dzid26/ESP32-DualCAN/hardware/esp32-c6-super-mini-com-wifi-e-bluetooth-com-usb-c.jpg

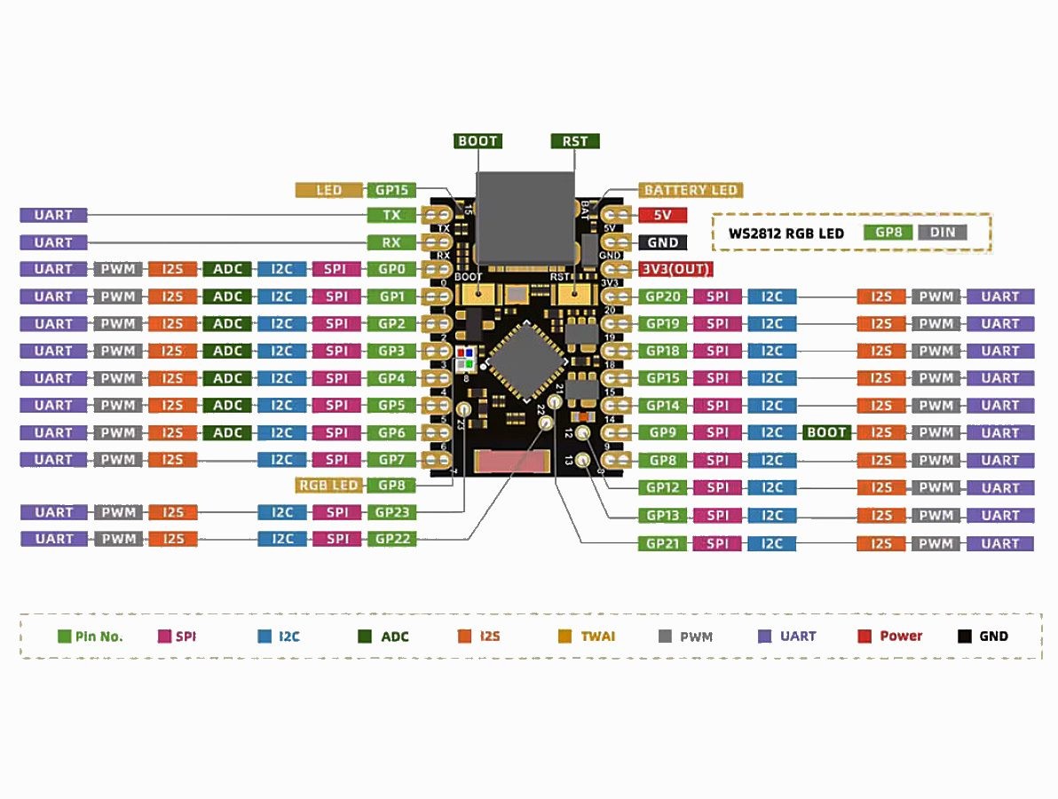
hardware/esp32-c6-super-mini-com-wifi-e-bluetooth-com-usb-c.jpg
