dzid26/ESP32-DualCAN/hardware/README.md

# Hardware — ESP32-DualCAN

 

## Characteristics
- 9-58 V operating range (e.g. Cybertruck),
- 5V rail: 0.5A continuous at room temp
- Dual CAN
- integrated 2.4 GHz antenna
- RGB LED
- USB-C - USB CDC (virtual COM, debugging)  

## Case
Designed in FreeCAD
- size 23.5 x 42.8 x 12.3 mm

## ICs
- ESP32-C6-Zero (ESP32-C6FH8, 8MB, BLE + WiFi, 2x TWAI CAN2.0 controllers)
- 2x CAN transceivers TCAN1044
- TI LV2862 DC/DC converter

## PCB
Designed in Kicad
- size 19.5 x 41.5 mm

## Images
- ESP32-C6-Zero chiplet and Molex connector:



- On the other side there are components and optional pads to solder cables with a female [connector](https://duckduckgo.com/?q=MX2.54+cable+6p) to daisy chain with s3xy buttons or a strip:



- It can accommodate optional female 2.54mm headers for custom extensions:



## Schematic



Source files: [`ESP32-DualCAN.kicad_sch`](ESP32-DualCAN.kicad_sch), [`ESP32-DualCAN.kicad_pcb`](ESP32-DualCAN.kicad_pcb) — see [KiCad-Waveshare-ESP32/](KiCad-Waveshare-ESP32/) for the ESP32-C6-Zero module footprint.
