dzid26/ESP32-DualCAN/hardware/KiCad-Waveshare-ESP32/README.md

# Waveshare ESP32-C6-Zero KiCad Footprint & Symbol

This is a KiCad Symbol and Footprint library for some select Waveshare ESP32 boards.
