dzid26/ESP32-DualCAN/docs/scripting.md

# Dorky Commander — Scripting Reference

> **💡 This is where the fun begins.** You can turn your commander into a smart device that reacts to the car CAN signals. Dive in!

> Scripting is based on Berry - a Python like language: <https://berry-lang.github.io/>

Scripts are `.be` files stored on LittleFS under `/scripts/`. Saving can also
write a `.bep` preprocessed runtime file with DBC names linked to numeric refs.
Each source file can carry metadata comments at the top and must define a `setup()` function.

## Script structure

```berry
# @name My script
# @description What it does
# @bus 0

var my_var = 0

def setup()
  # called when the script is enabled — register callbacks and timers here
  timer_every(1000, def()
    print("tick " .. str(my_var))
    my_var += 1
  end)
end

def teardown()
  # called when the script is disabled (optional)
  print("bye")
end
```

Metadata fields (`@name`, `@description`, `@bus`) appear in the web UI.

## Function reference

### High-level API *(user-facing — write these directly in scripts)*

**High-level API** (write these directly; the preprocessor resolves the DBC name forms described below):

| Function | Returns | Description |
|---|---|---|
| `can_msg_new(name)` | draft \| nil | Create zeroed draft from DBC name (name→ID+DLC resolved at compile time) |
| `can_msg_new(id, dlc)` | draft \| nil | Create zeroed draft from numeric ID and DLC |
| `can_msg_get(bus, id \| name)` | draft \| nil | Latest received frame as editable draft — bus is first |
| `can_msg_send(bus, draft)` | — | Transmit the draft on bus (auto-handles checksum/counter) |
| `can_send_raw(bus, id, data)` | — | Transmit a raw CAN frame (max 8 bytes) |
| `can_recv_raw(bus, msg_id [, timeout_ms])` | bytes \| nil | Last payload for a CAN ID. Default 1000 ms timeout — blocks up to 1 s for initial data. Pass 0 for instant return. |
| `timer_after(ms, fn)` | handle | Fire fn once after ms |
| `timer_every(ms, fn)` | handle | Fire fn every ms |
| `timer_cancel(handle)` | — | Cancel a timer by handle |
| `action_register(name, fn)` | — | Register a Dashboard tile |
| `action_invoke(name)` | — | Invoke an action by name |
| `led_set(r, g, b)` | — | On-board RGB LED (0–255 each) |
| `led_off()` | — | Turn off LED |
| `state_set(key, val)` | — | Write string to NVS flash |
| `state_get(key [, default])` | str \| nil | Read string from NVS flash |
| `state_remove(key)` | — | Delete key from NVS flash |
| `millis()` | int | Milliseconds since boot |
| `print(msg)` | — | Log to web UI panel |
| `str(v)` | string | Convert any value to string |
| `format(fmt, ...)` | string | C-style string formatting |

Timers and actions belong to the script that registered them, including when
they are registered from inside a timer callback or an action. Disabling the
script cancels them. `teardown()` runs before that sweep, so a timer started
from `teardown()` is cancelled too — `teardown()` cannot defer work.

**Renamed or rewritten by the preprocessor** (the call you write is replaced
at compile time — writing them without a DBC loaded will produce errors):

| Source (what you write) | Becomes (after preprocessing) |
|---|---|---|
| `can_msg_get(bus, "msg")` | `can_msg_get(bus, 0xID)` |
| `can_msg_new("msg")` | `can_msg_new(0xID, dlc)` |
| `msg_sig_set(draft, "sig", val)` | `msg_sig_set(draft, sb, len, be, signed, scale, offset, val)`, the full encode with scale and offset |
| `msg_sig_get(draft, "sig")` | `msg_sig_get(draft, sb, len, be, signed, scale, offset)`, the full decode with scale and offset |

The preprocessor reads source with the same lexical rules as the firmware Berry
compiler. `#` line comments and `#- ... -#` block comments are ignored; strings
use either quote style, support Berry escapes, and adjacent literals
(`"DAS_" "bodyControls"`) are one name. A string cannot contain a raw newline.
Calls must put `(` immediately after the name. `can_msg_get (0, "msg")` is a
grouping expression to Berry, not a call, so the preprocessor reports it
instead of silently repairing it.

These calls can nest. The common case is incrementing a counter field in place:

```berry
var msg = can_msg_get(0, "UI_powertrainControl")
msg_sig_set(msg, "UI_powertrainControlCounter",
  (int(msg_sig_get(msg, "UI_powertrainControlCounter")) + 1) % 16)
```

The inner read is inlined to full metadata and the outer write keeps the whole
expression intact.

Diagnostics carry `line:column`. Saving is blocked when a message or signal name
is unknown, a name is not a compile-time string literal, the argument count is
wrong, a tracked draft's message does not contain the signal, or a call is
unbalanced. A balanced call that cannot be resolved is replaced with
`assert(false, "message")`, which is valid Berry in expression position. The
rest of the file is still preprocessed. An unbalanced call is left in place and
reported, and the upload is blocked.

When a signal name appears in more than one message and the draft's owning
message cannot be determined (an untracked or multi-assigned variable), the
first match is used and a non-fatal **warning** is reported in the web UI.
The owning message comes from a tracked variable or from an inline
`can_msg_get`/`can_msg_new` call. Bind the draft so resolution is exact.

`can_msg_new` accepts `"msg"` or `(id, dlc)`. For compatibility it also accepts
`("msg", ignored)` and `(ignored, "msg")`. The DBC's ID and DLC are used. A
one-argument numeric call such as `can_msg_new(0x294)` is rejected because the
runtime binding requires both ID and DLC.

The four names are treated as the firmware intrinsics when called directly. A
definition such as `def can_msg_get(x)` is left alone, and a member call such as
`obj.can_msg_get(...)` is left alone. A later direct call to the intrinsic name
is still rewritten even if that name was shadowed. A call through a different
alias is not recognized. Calls inside f-string interpolation are not rewritten.
Build the string after the call. A non-literal second argument to
`can_msg_get` is left for the runtime, so `can_msg_get(0, msgIdVar)` remains
valid for a numeric ID.

### Low-level inline forms *(generated by the preprocessor. Do not write these manually.)*

| Generated form | Meaning |
|---|---|
| `can_msg_get(bus, 0xID)` | latest frame for a numeric message ID |
| `can_msg_new(0xID, dlc)` | zeroed draft from a numeric ID and DLC |
| `msg_sig_get(draft, sb, len, be, signed, scale, offset)` | decode a signal |
| `msg_sig_set(draft, sb, len, be, signed, scale, offset, val)` | encode a signal |

`sb` is the start bit, `len` is the bit length, `be` is big-endian, `signed` is
signed, and `scale` and `offset` are the DBC conversion. These are what a `.bep`
contains. Write the named calls in `.be` source.

---

## CAN signals  *(requires a DBC loaded on the target bus)*

```berry
# Poll a signal via message draft + timer.
# can_msg_get returns the latest received frame for a given bus + message ID.
var d = can_msg_get(0, "VCRIGHT_doorStatus")
if d != nil
  var v = msg_sig_get(d, "VCRIGHT_frontHandlePulled")
  print("handle: " .. str(v))
end

# Read current value synchronously (returns a map or nil).
var d = can_msg_get(0, "DI_speed")
var m = 0
if d != nil m = msg_sig_get(d, "DI_vehicleSpeed") end
if m != nil
  print("speed: " .. str(m['value']))
end
```

## Raw CAN frames

```berry
# Send a raw frame: bus (0 or 1), CAN ID (integer), payload (bytes object, max 8).
var b = bytes("01FF")               # from hex string
can_send_raw(0, 0x100, b)

# Using setbits(offset_bits, len_bits, val) — chainable, returns self.
# UI_mirrorFoldRequest at bit 24, 2 bits, value 0x2 (unfold):
can_send_raw(0, 0x273, bytes(-8).setbits(24, 2, 0x2))

# Read the last received payload bytes for a specific CAN ID:
# Default timeout is 1 s — blocks up to 1 s for initial data.
# Pass timeout_ms=0 for instant return (retuns nil if no data yet).
var payload = can_recv_raw(0, 0x118)
if payload != nil
  print("DI_state: " .. str(payload))
end
```
Note: long timeouts are not recommended - as they block all berry scripts.

## Encoded messages  *(requires DBC)*

```berry
# Create a fresh zeroed draft from DBC (name → ID + DLC resolved at compile time)
var msg = can_msg_new("UI_powertrainControl")
# Or with numeric ID, DLC:  can_msg_new(0x313, 8)
msg_sig_set(msg, "UI_trackModeRequest", 1)
can_msg_send(0, msg)                           # bus, msg

# Or fetch the latest received frame as a modifiable draft
var msg2 = can_msg_get(0, "UI_powertrainControl")   # bus first, then DBC name
# or by numeric CAN ID: can_msg_get(0, 0x313)
msg_sig_set(msg2, "UI_trackModeRequest", 1)
can_msg_send(0, msg2)
```

The draft is a map instance with keys `id` (int), `data` (bytes), `dlc` (int). You can read/write individual signals with `msg_sig_set`, or access the raw data buffer directly: `msg["data"]`.

### Low-level bit encoding (used by the preprocessor, exposed for custom work)

```berry
# Extract a raw integer bit field from bytes.
var raw = bit_extract(data, 0, 2, false)   # start_bit=0, len=2, little_endian

# Insert a raw integer into bytes, returns a new bytes copy.
var encoded = bit_insert(data, 0, 2, false, 3)

# Decode/encode are done via msg_sig_get / msg_sig_set on a draft — see below.
```

### AI authoring guidance

When writing scripts that inject a vehicle command frame, send only the intended command frame unless the user explicitly asks for a release/reset frame. No need to set up periodic reset - the vehicle will take care of resetting the state back to idle or similar.

---

## Timers

```berry
# Fire once after 500 ms. Returns a handle (int).
var h1 = timer_after(500, def()
  print("fired once")
end)

# Fire every 200 ms. Returns a handle (int) for cancellation.
var h2 = timer_every(200, def()
  print("every 200 ms")
end)

# Cancel by handle (no-op if handle is invalid or already fired).
timer_cancel(h2)
```

---

## Actions  *(appear as tiles on the Events page)*

```berry
action_register("my_action", def()
  print("tile tapped")
  led_set(0, 40, 0)
  timer_after(200, /-> led_off())
end)

action_invoke("my_action")   # call programmatically
```

---

## LED

```berry
led_set(40, 0, 0)   # r, g, b  (0–255 each)
led_off()
```

---

## Persistent storage  *(NVS flash — survives reboot)*

```berry
state_set("my_key", "hello")          # write a string
var v = state_get("my_key", "fallback")  # read, with default
state_remove("my_key")                  # delete key
```

---

## Berry lang syntax cheat sheet

```berry
var x = 0                        # variable
x += 1                           # compound assignment

def greet(name)                  # function definition
  print("hi " .. name)
end

if x > 10                        # if / elif / else / end
  print("big")
elif x > 5
  print("medium")
else
  print("small")
end

for i: 0..4                      # range loop (inclusive on both ends)
  print(str(i))
end

while x > 0                      # while loop
  x -= 1
end

var fn = /-> print("lambda")     # zero-arg lambda
var fn2 = def(a) a * 2 end       # inline function expression

var b = bytes(-8)                 # fixed 8-byte buffer, zero-filled
b.setbits(24, 2, 2)               # signal at bit 24, 2 bits, value 2 (PRESENT)
var b2 = bytes('deadbeef0011')    # 8 bytes from hex string
b.item(0)                         # read by index
```

## `setbits`

Writes a bit-level value into a `bytes` buffer. Chainable — returns `self`.

Works natively with **Intel (little-endian) unsigned** DBC signals — the most common format. For Motorola (big-endian) or signed signals, convert offset/value before calling.

| Parameter | Unit | Range |
|---|---|---|
| `offset_bits` | bits | `0`+ |
| `len_bits` | bits | `1`..`32` |
| `val` | integer | uses only lower `len_bits` |

```berry
# arbitrary bit offset, no need for byte alignment
can_send_raw(0, 0x273, bytes(-8).setbits(24, 2, 2))
```

More here - [Berry-in-20-minutes](https://berry.readthedocs.io/en/latest/source/en/Berry-in-20-minutes.html)
