dzid26/ESP32-DualCAN/hardware/case/case.FCStd

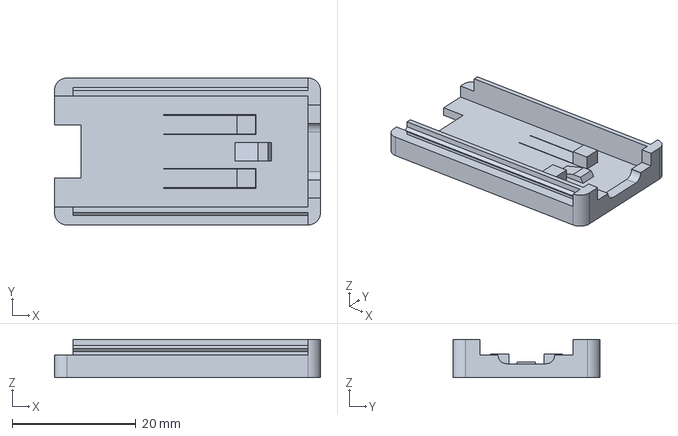
[picture p2: CAD file, 2026-04-22]
hardware/case/case.FCStd
43.0 x 23.8 x 6.20 mm
