dzid26/ESP32-DualCAN/hardware/footprints/CONN_1719760000.step

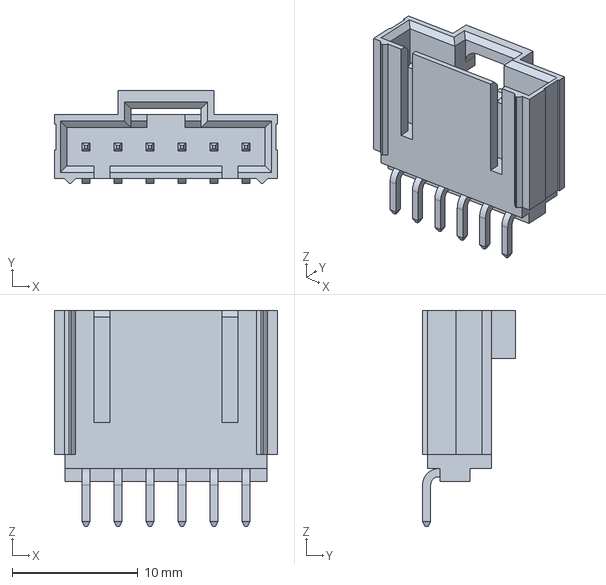
[picture p3: CAD file, 2026-03-16]
hardware/footprints/CONN_1719760000.step
17.7 x 7.38 x 17.1 mm
