dzid26/ESP32-DualCAN/hardware/footprints/CONN_705530005.step

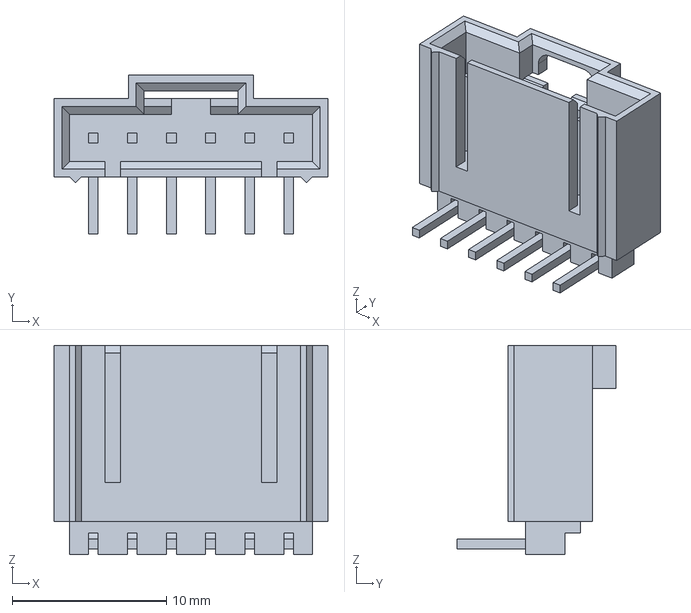
[picture p4: CAD file, 2026-03-16]
hardware/footprints/CONN_705530005.step
17.8 x 10.3 x 13.6 mm
