dzid26/ESP32-DualCAN/hardware/footprints/CONN_0705510040.step

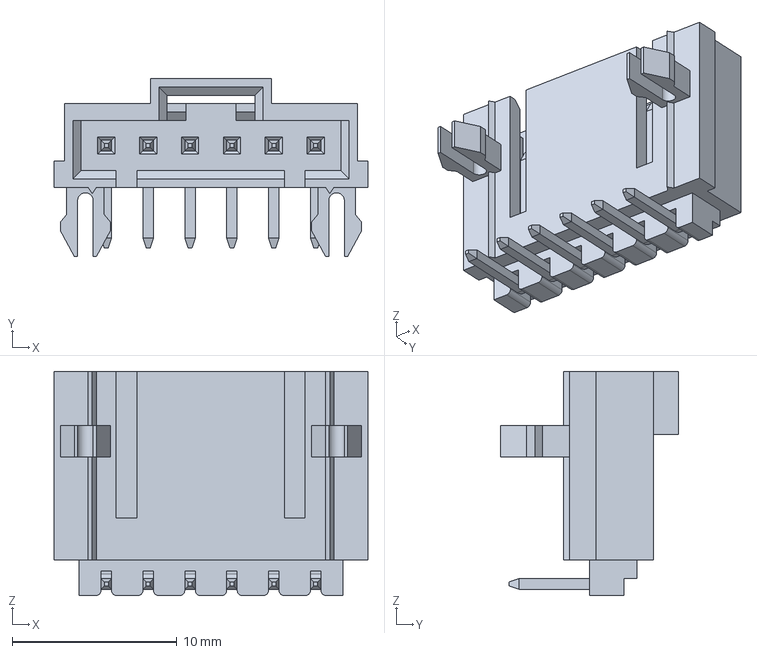
[picture p5: CAD file, 2026-02-19]
hardware/footprints/CONN_0705510040.step
19.0 x 10.8 x 13.6 mm
