dzid26/ESP32-DualCAN/hardware/ESP32-DualCAN.kicad_pcb

## KiCad design hardware/ESP32-DualCAN.kicad_pcb (2026-10-12)

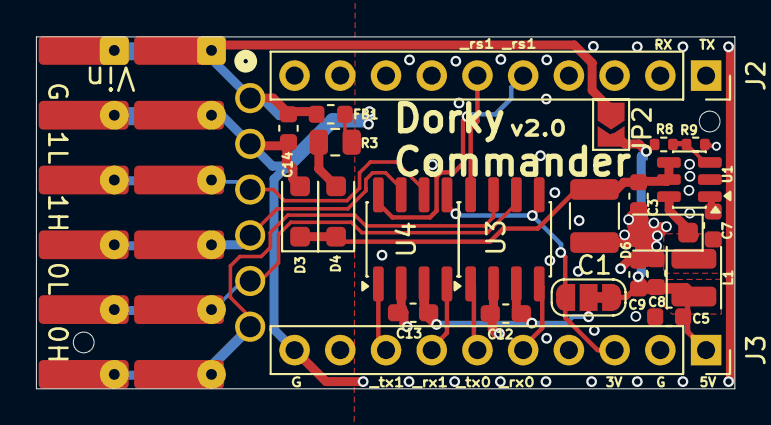
[picture p6: board ESP32-DualCAN.kicad_pcb from above]

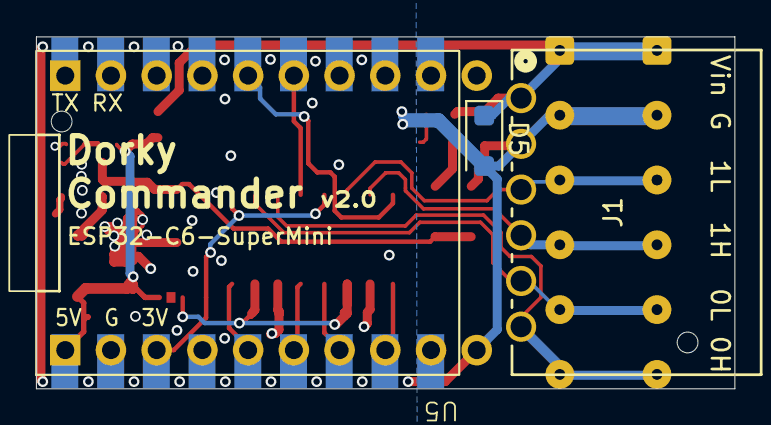
[picture p7: board ESP32-DualCAN.kicad_pcb from below]

Board: 2 copper layers, 38.8 x 19.6 mm, 31 parts (3 on the bottom side), 30 nets.

Parts:
C1: 10u 100v; C_1210_3225Metric
C3, C14: 100n 100V; C_0603_1608Metric
C5, C9: 22u; C_0603_1608Metric
C7, C8: 100n; C_0603_1608Metric
C12, C13: 100n; C_0603_1608Metric_Pad1.08x0.95mm_HandSolder
D3, D6: DSK38; D_SOD-123F
D4: SMF58A; D_SOD-123F
D5: SMF30CA; D_SOD-123F
FB1: FerriteBead; L_0603_1608Metric
J1: Molex 70553 6p; CONN_705530005_06_MOL
J2, J3: Conn_01x10_Socket; PinSocket_1x10_P2.54mm_Vertical
J4, J6: holes; SolderWire-0.1sqmm_1x06_P3.6mm_D0.4mm_OD1mm
J5, J7: pads; SolderWire-0.1sqmm_1x06_P3.6mm_D0.4mm_OD1mm
JP1: SolderJumper_3_Bridged12; SolderJumper-3_P1.3mm_Bridged12_RoundedPad1.0x1.5mm_NumberL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
JP2: SolderJumper_2_Open; SolderJumper-2_P1.3mm_Open_TrianglePad1.0x1.5mm
L1: 22uH; L_Changjiang_FTC322520S
R3: 1ohm; R_0805_2012Metric
R8: 56k; R_0402_1005Metric
R9: 10k; R_0402_1005Metric
U1: MLMR16006Y; TSOT-23-6
U3, U4: TCAN1044AV; SOIC-8_3.9x4.9mm_P1.27mm
U5: ESP32-C6-Zero; Waveshare-ESP32-C6-Zero

Connections:
+3.3V: J3.3, JP1.3 (B), U3.5 (VIO), U4.5 (VIO), U5.3 (V3V)
+BATT: C14.1, D5.1 (A1), FB1.1, J1.1, J4.1, J5.1, J6.1, J7.1, JP2.1 (A)
/BATT_Diode: C1.1, C3.1, D3.1 (K), D4.1 (A1), U1.4 (EN), U1.5 (VIN)
CAN0_H: J1.6, J4.6, J5.6, J6.6, J7.6, U3.7 (CANH)
CAN0_L: J1.5, J4.5, J5.5, J6.5, J7.5, U3.6 (CANL)
CAN0_RS: J2.6, U3.8 (STB), U5.13 (IO19)
CAN0_RXD: J3.5, U3.4 (RXD), U5.5 (IO1)
CAN0_TXD: J3.6, U3.1 (TXD), U5.6 (IO2)
CAN1_H: J1.4, J4.4, J5.4, J6.4, J7.4, U4.7 (CANH)
CAN1_L: J1.3, J4.3, J5.3, J6.3, J7.3, U4.6 (CANL)
CAN1_RS: J2.5, U4.8 (STB), U5.14 (IO18)
CAN1_RXD: J3.7, U4.4 (RXD), U5.7 (IO3)
CAN1_TXD: J3.8, U4.1 (TXD), U5.8 (IO4)
GND: C1.2, C3.2, C5.2, C8.2, C9.2, C12.2, C13.2, C14.2, D4.2 (A2), D5.2 (A2), D6.2 (A), J1.2, J3.2, J3.10, J4.2, J5.2, J6.2, J7.2, R9.1, U1.2 (GND), U3.2 (GND), U4.2 (GND), U5.2 (GND)
unnamed: D3.2 (A), R3.2
unnamed: C7.2, D6.1 (K), L1.1, U1.6 (SW)
unnamed: FB1.2, R3.1
unnamed: J2.1, U5.18 (TX)
unnamed: J2.2, U5.17 (RX)
unnamed: J2.3, U5.16 (IO14)
unnamed: J2.4, U5.15 (IO15)
unnamed: J2.7, U5.12 (IO20)
unnamed: J2.8, U5.11 (IO21)
unnamed: J2.9, U5.10 (IO22)
unnamed: J3.4, U5.4 (IO0)
unnamed: J3.9, U5.9 (IO5)
unnamed: C12.1, C13.1, JP1.2 (C), U3.3 (VCC), U4.3 (VCC)
unnamed: C7.1, U1.1 (BOOST)
unnamed: R8.1, R9.2, U1.3 (FB)
VCC: C5.1, C8.1, C9.1, J3.1, JP1.1 (A), JP2.2 (B), L1.2, R8.2, U5.1 (VCC)
