dzid26/ESP32-DualCAN/firmware/src/can/can.h

#pragma once

#include <stdbool.h>
#include <stdint.h>

#include "driver/twai.h"
#include "can/rate_limit.h"

#define CAN_MSG_CACHE_MAX   64  /* number of CAN IDs that can be cached */
#define CAN_FRAME_CACHE    3  /* ring buffer depth per cache slot */

/* CAN-layer error codes */
#define CAN_ERR_FULL    (-202)
#define CAN_ERR_NO_FRAME (-203)

/* Ring buffer of twai_message_t at fixed depth (CAN_FRAME_CACHE).
 * frames[0].identifier == 0 means a cache slot is free.
 * last_us = esp_timer_get_time() at most recent push (microseconds). */
typedef struct {
    twai_message_t frames[CAN_FRAME_CACHE]; // mini ring buffer
    uint8_t        head;     /* next write index */
    uint8_t        count;    /* frames stored (0..CAN_FRAME_CACHE) */
    uint32_t       last_us;  /* μs timestamp of most recent push */
} msg_ring_t;

typedef struct {
    int                bus_id;
    rate_limiter_t     rate_limiter;
    bool               loaded;
    bool               sim_mode;       /* true = TX goes to log, not bus */

    /* Frame cache: per-ID ring buffers. Only caches IDs scripts have read. */
    msg_ring_t         msg_cache[CAN_MSG_CACHE_MAX];
} can_t;

int  can_init(can_t *c, int bus_id);
void can_free(can_t *c);
int  can_poll(can_t *c, uint32_t now_ms);

/* Raw frame observer — called for every frame received on any bus.
 * Used by the trace feature to forward frames to the UI. Single global slot. */
typedef void (*can_raw_observer_t)(int bus_id, const twai_message_t *frame, uint32_t now_ms);
void     can_set_raw_observer(can_raw_observer_t cb);
uint32_t can_last_rx_ms(int bus_id);  /* ms timestamp of last received frame, 0 if none */
uint16_t can_bus_rx_rate(int bus_id); /* RX frames/sec over last ~1 s, 0 when idle */

/* Non-blocking (timeout_ms == 0) or blocking read (default 1000 ms):
 * ensure msg_id slot exists, returns last frame data when available or -1. */
int  can_read(can_t *c, uint32_t msg_id, uint8_t *out_data, uint8_t *out_dlc, uint32_t timeout_ms);

/* Send a raw CAN frame. Rate-limited per ID. */
int  can_send(can_t *c, uint32_t id, const uint8_t *data, uint8_t dlc);

void can_set_sim_mode(can_t *c, bool enabled);
