dzid26/ESP32-DualCAN/(commit log)

2026-02-19 ESP32-C6-MINI-1 + SN65HVD230 + USB-C
    [CONN_0705510040.step, ESP32-DualCAN.kicad_pcb, ESP32-DualCAN.kicad_sch]
2026-03-10 Moved CAN0 pins. Added UART tap points.
    [ESP32-DualCAN.kicad_pcb, ESP32-DualCAN.kicad_sch]
2026-03-16 ESP32-C6-Zero main
    [CONN_1719760000.step, CONN_705530005.step, ESP32-DualCAN.kicad_pcb, ESP32-DualCAN.kicad_sch]
2026-03-16 ESP32-C6-SuperMini as main
    [ESP32-DualCAN.kicad_pcb, ESP32-DualCAN.kicad_sch]
2026-03-23 horizontal layout
    [ESP32-DualCAN.kicad_pcb]
2026-03-23 /PCB folder
    [CONN_0705510040.step, CONN_1719760000.step, CONN_705530005.step, ESP32-DualCAN.kicad_pcb, ESP32-DualCAN.kicad_sch]
2026-04-12 Fixed silk labels
    [ESP32-DualCAN.kicad_pcb]
2026-04-14 firmware: add hardware-in-the-loop test scaffolding
    - TWAI dual-CAN loopback test (test_hw_loopback) and RGB LED smoke
    test (test_hw_led) running on ESP32-C6-SuperMini under the Arduino
    framework via pioarduino.
    - Custom unity_config.{h,cpp} that skips Serial.end() in
    unityOutputComplete() — on ESP32-C6 HWCDC that call pulls USB D+/D-
    low and kills enumeration until a hardware reset
    (platformio-core#5359).
    - Minimal platformio.ini for `pio test -e esp32-c6-tests-arduino`,
    plus .gitignore for generated sdkconfig / caches.
    [test_loopback.cpp, unity_config.cpp]
2026-04-16 firmware: add ESP-IDF production skeleton, architecture docs, native tests
    - Minimal ESP-IDF app (CMakeLists.txt, src/CMakeLists.txt, src/main.c,
    sdkconfig.defaults) routing ESP_LOG to USB-Serial-JTAG since UART0 is
    not broken out on the ESP32-C6-SuperMini.
    - platformio.ini gains a tests-native env for host unit tests alongside
    the existing esp32-c6-tests-arduino HIL env.
    - ARCHITECTURE.md spec and ROADMAP.md phased plan covering the
    firmware, scripting engine (Berry), dual BLE/WS transport, web UI,
    reverse-engineering tools, and test strategy.
    - First host unit test (test_native_checksum) covering the Tesla CAN
    checksum algorithm with hand-computed vectors.
    - Tesla Model 3 DBCs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
    [main.c]
2026-04-16 rename PCB/ to hardware/
    Align folder name with its broader scope (KiCad project, footprints,
    fabrication config, reference images). Updates the two path references
    in firmware/ARCHITECTURE.md.
    [CONN_0705510040.step, CONN_1719760000.step, CONN_705530005.step, ESP32-DualCAN.kicad_pcb, ESP32-DualCAN.kicad_sch]
2026-04-16 firmware: declare 4 MB flash for ESP32-C6-SuperMini
    The esp32-c6-devkitm-1 board preset assumes 2 MB, but the SuperMini
    module ships with 4 MB. `board_upload.flash_size = 4MB` is read by the
    espressif32 ESP-IDF builder and auto-propagates to sdkconfig as
    CONFIG_ESPTOOLPY_FLASHSIZE_4MB so the partition table and bootloader
    are sized for the actual chip.
    Also drop the redundant `build_type = release` — release is PIO's
    default and setting it explicitly just adds noise.
2026-04-16 firmware: port dual-TWAI bringup into production code
    - src/can/can_bus.{h,c}: thin wrapper over the TWAI v2 driver with
    install / send / receive / status for up to two buses. Drives the
    TCAN1044 STB pin low on install so the transceiver leaves standby.
    - main.c: init both buses at 500 kbit/s on the SuperMini pins
    (CAN0: GPIO2/1/19, CAN1: GPIO4/3/18), TX a tick frame on ID 0x123
    on CAN0 every second, drain and log any RX from both buses, toggle
    GPIO 15 LED as a liveness indicator.
    - src/CMakeLists.txt: narrow glob to .c/.cpp, add INCLUDE_DIRS "." so
    "can/can_bus.h" resolves, and declare REQUIRES esp_driver_twai
    esp_driver_gpio.
    - Verified on the board with the CAN0<->CAN1 bridg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
    [can_bus.c, main.c]
2026-04-16 firmware: integrate Berry scripting VM via submodule
    - Add berry-lang/berry as a git submodule at
    firmware/components/berry/berry/ (pinned at 3db3ef5, master).
    - ESP-IDF component wrapper in components/berry/CMakeLists.txt:
    compiles all upstream src/*.c except be_repl.c and be_filelib.c,
    plus our port/ files.
    - port/berry_conf.h tuned for ESP32-C6: single-precision float,
    32-bit integers, no filesystem, minimal module set (string, global,
    gc, introspect), stack max 2000, precompiled objects on.
    - port/be_port.c routes Berry's print() to ESP_LOGI, stubs all file
    I/O, provides be_nfunc_open() stub for the open() builtin.
    - port/be_modtab.c copied from upstream (module table control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
2026-04-16 firmware: Berry CAN loopback demo with RGB LED — phase 0 complete
    - Berry native bindings (src/scripting/berry_bindings.{h,c}):
    can_send(bus, id, data), can_receive(bus), led_set(r, g, b), led_off().
    Registered as global functions in the VM.
    - RGB LED driver (src/led/led_rgb.{h,c}): WS2812 on GPIO 8 via the
    espressif/led_strip managed component (src/idf_component.yml).
    - Demo script hardcoded in main.c: Berry loop() runs at 10 Hz, TX a
    counter frame on CAN0 (ID 0x123), poll CAN1 — green on rx, red on
    miss. Also bridges CAN0 rx to CAN1.
    - .gitignore: managed_components/ and dependencies.lock.
    Verified on hardware: LED glows green with CAN0<->CAN1 bridge jig.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
    [main.c]
2026-04-16 firmware: add free-heap and FreeRTOS CPU usage stats logging
    Print free heap and per-task CPU usage every 10 s. Requires a full
    rebuild after this change since sdkconfig.defaults enables
    FREERTOS_GENERATE_RUN_TIME_STATS and FREERTOS_USE_TRACE_FACILITY.
2026-04-16 ci: add GitHub Actions firmware workflow, update docs
    - .github/workflows/firmware.yml: host-tests job (pio test -e
    tests-native) and firmware-build job (pio run -e esp32-c6) with
    caching. Triggered on firmware/ changes.
    - ROADMAP.md: add AI-assisted script editor to parking lot, update
    phase 4 engine sound idea.
    - ARCHITECTURE.md: folder structure reflects current state.
    - platformio.ini: add monitor_rts/monitor_dtr=0 to prevent ESP32-C6
    USB-Serial-JTAG reset on monitor open.
2026-04-16 firmware: add DBC binary format, signal decoder, and signal cache
    Binary DBC format (dbc_types.h):
    - Compact memory-mappable format: 28-byte header, 12 bytes/message
    (sorted by ID for binary search), 16 bytes/signal, packed string
    table. Designed for zero-copy loading from a buffer.
    - Supports little-endian and big-endian signals, signed/unsigned,
    multiplexed messages (selector + muxed signals).
    Decoder (dbc_decode.{h,c}):
    - dbc_load(): validate and map a binary blob.
    - dbc_find_msg(): binary search by CAN ID.
    - dbc_find_signal(): linear scan by name.
    - dbc_extract_raw(): bit extraction for both Intel and Motorola byte
    order, handles arbitrary start_bit and bit_length up to 64 bits.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
2026-04-16 firmware: add message mirror with auto checksum/counter for TX
    msg_mirror.{h,c}: per-message latest-rx-bytes storage for the
    "modify one signal, preserve the rest" send pattern.
    - msg_mirror_rx(): update mirror on frame receipt.
    - msg_mirror_draft(): get a writable copy of the latest frame.
    - msg_mirror_prepare_tx(): auto-increment *_Counter signals (mod
    2^width) and auto-compute *_Checksum signals using the Tesla CAN
    checksum algorithm. Counter is incremented before checksum so the
    checksum covers the new counter value.
    - tesla_checksum() exported for direct use from Berry scripts.
    - Signal name suffix matching (_Counter, _Checksum) is
    case-sensitive, matching Tesla DBC conventions.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
2026-04-16 firmware: add CAN engine, decoded signal Berry bindings, embedded DBC
    CAN engine (src/can/can_engine.{h,c}):
    - Orchestrates DBC + signal cache + message mirror per bus.
    - can_engine_poll(): drains rx queue, decodes signals, updates cache
    and mirror, fires registered on-change callbacks.
    - can_engine_on_change(): register a C callback for a signal by name.
    - can_engine_signal(): look up current signal cache entry by name.
    - can_engine_draft/encode/send(): message draft→modify→transmit flow
    with auto checksum/counter.
    Berry bindings (extended berry_bindings.c):
    - can_signal(name [, bus]): returns map {value, prev, age_ms, changed}
    from the signal cache.
    - can_on(name, fn [, bus]): r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
    [main.c]
2026-04-16 firmware: add LittleFS, custom partition table, and script loader
    Partition table (partitions.csv): 4 MB flash split into NVS (16 KB),
    OTA data (8 KB), phy_init (4 KB), two 1.5 MB OTA app slots, and a
    960 KB LittleFS partition for scripts, DBC binaries, and web UI.
    LittleFS (storage/fs.{h,c}): mounts at /littlefs using the
    joltwallet/littlefs managed component. Auto-formats on first boot.
    Script loader (scripting/script_loader.{h,c}):
    - script_loader_scan(): reads /littlefs/scripts/ for .be files.
    - script_loader_enable(): reads file, executes it (defines functions),
    calls setup() if present. Errors are captured per-script.
    - script_loader_disable(): calls teardown(), marks script inacti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
    [partitions.csv]
2026-04-16 firmware: add NVS-backed state for Berry scripts
    state.{h,c}: thin wrapper over ESP-IDF NVS for per-script persistent
    key-value storage. state_nvs_init() called at boot. Values stored as
    strings, keyed by script namespace + key.
    Berry bindings:
    - state_set(key, value): store a string in NVS.
    - state_get(key [, default]): retrieve; returns default or nil if
    missing.
    - state_remove(key): delete a key.
    Currently uses a single "script" namespace. Will be per-script once
    the script loader assigns namespaces from filenames.
    [main.c]
2026-04-16 firmware: add BLE GATT server for web UI transport
    BLE transport (src/ble/ble_transport.{h,c}):
    - NimBLE GATT server advertising as "Dorky" with a custom service
    using Nordic UART Service-style UUIDs.
    - RX characteristic (write/write-no-rsp): client sends commands.
    - TX characteristic (notify): server pushes responses/events.
    - dorky_ble_init(): starts NimBLE host task + advertising.
    - dorky_ble_notify(): send data to connected client.
    - dorky_ble_connected(): connection status check.
    - GAP handler: auto-restarts advertising on disconnect, logs MTU
    negotiation and subscription events.
    - Preferred MTU set to 512 for Web Bluetooth compatibility.
    sdkconfig.defaults: enable BT + NimBLE, max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
2026-04-16 firmware: refactor CAN/DBC module structure for clarity
    Reorganize so file names match their purpose and Tesla-specific
    logic is isolated from generic CAN operations.
    Renames:
    can_bus.{h,c} → can_driver.{h,c} (TWAI hardware wrapper)
    can_engine.{h,c} → can.{h,c} (per-bus state, poll, callbacks)
    dbc_decode.{h,c} → split into dbc_pack + msg_codec
    New files:
    can/msg_codec.{h,c} — bit extract/insert, scale/offset, frame-level
    decode/encode, signal_state_t. Pure functions, no hardware deps.
    can/tesla.{h,c} — Tesla checksum + counter finalization. Pluggable
    via tx_finalize_fn_t function pointer for other brands.
    dbc/dbc_pack.{h,c} — load binary DBC blob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
2026-04-16 firmware: add per-ID TX rate limiter and simulation mode
    rate_limit.{h,c}: per-CAN-ID send throttle. Default 100 Hz, per-ID
    overridable via rate_limiter_set(). Tracks last-tx timestamp per ID
    in microseconds. Excess sends are silently dropped with a debug log.
    can.c integration:
    - can_send() checks rate_limiter_allow() before transmitting. Dropped
    frames log at DEBUG level to avoid flooding.
    - Simulation mode (can_set_sim_mode): when enabled, can_send() logs
    the frame instead of putting it on the bus. Useful for testing
    scripts without being in the car.
    [can.c, can.h, rate_limit.c, rate_limit.h]
2026-04-16 webui: scaffold Svelte 5 + Vite + TypeScript web UI
    Svelte 5 project at webui/ with three initial views:
    - Scripts: textarea editor for Berry code (Monaco will replace this).
    Upload & Enable / Disable buttons (wired to BLE transport).
    - DBC: file upload, browser-side DBC text parser + binary compiler
    (src/dbc/parser.ts — TypeScript port of firmware/scripts/dbc2bin.py).
    Displays parsed messages/signals. Upload to bus 0 or 1.
    - Dashboard: placeholder for live signal watch + graphs.
    Transport layer (src/transport/):
    - types.ts: Transport interface (connect, disconnect, send, onReceive).
    - ble.ts: BleTransport using Web Bluetooth API with Nordic UART
    Service UUIDs matching the firmwa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
2026-04-16 add demo scripts, CAN TX logging, and Tesla DBC preset in web UI
    Example Berry scripts (firmware/scripts_examples/):
    - loopback_led.be: CAN0→CAN1 loopback with RGB LED feedback.
    - bench_test.be: sends periodic frames on 3 IDs, logs rx, cycles LED.
    Designed for testing without a car — watch serial monitor.
    - window_drop_on_handle_pull.be: template for the door-handle window
    automation using decoded signals (can_on callbacks).
    - track_mode_on_full_throttle.be: template for track mode request.
    CAN TX logging: can_driver.c now logs every successful transmit at
    INFO level so sent frames are visible in pio device monitor.
    Web UI DBC view: "Load Tesla Model 3 defaults" button fetches the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
2026-04-18 case initial
    [case.FCStd]
2026-04-20 wire BLE protocol: script upload/enable/disable from web UI
    Adds a JSON-over-BLE request/response layer so the Scripts view can
    save, list, enable, and disable Berry scripts on the device without
    a manual reflash. Also fixes a Berry VM stack leak (be_getglobal
    always pushes; be_pop was missing in the no-loop-defined path,
    causing a watchdog trigger after ~480 idle iterations).
    - firmware/src/protocol/: new JSON framing layer (4-byte length
    prefix, cJSON dispatch, chunked BLE notify for large responses)
    - main.c: wire protocol_init + dorky_ble_init with real callback;
    remove dead demo script
    - CMakeLists.txt: add `json` component for cJSON
    - webui/src/transport/protocol.ts: Protocol clas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
    [main.c]
2026-04-20 fix script enable/disable and wire script delete; improve BLE reactivity
    - Fix Berry VM nil-callable crash: use be_isfunction() guard instead of
    be_getglobal() return value (which returns true even for nil globals)
    - Fix cross-script interference: remove blanket global nulling on disable;
    gate main loop on any_loaded check per-script instead
    - Add script.delete command (firmware protocol + script_loader_delete +
    TS client + del button in Scripts view)
    - Remove redundant top-row Enable/Disable buttons from Scripts UI
    - BLE reactivity: onConnectionChange callback keeps App.svelte connected
    state in sync on unexpected drops; pass reactive connected prop to views
    - Auto-reconnect on page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
    [main.c]
2026-04-21 wider cable slot
    [case.FCStd]
2026-04-22 buttons and fixes
    [case.FCStd]
2026-04-29 script loading - no loop() - use timer registration
    Firmware
    script_loader.c — assigns a unique script_id, captures setup/teardown into refs and clears the globals so scripts can't see each other's hooks; on disable it calls teardown via the captured ref then berry_cleanup_script(id) to revoke every tagged can.on / timer / action. Defining loop() now logs a warning telling the user to use timer_every.
    berry_bindings.c / .h — exposes berry_capture_global / release_ref / call_ref / timer_tick.
    main.c — dropped the loop() polling, calls berry_timer_tick(now) each iteration.
    bench_test.be — migrated to timer_every(100, tick_fn) registered from setup().
    Web UI
2026-04-29 Blink LED on CAN rx. CPU usage print
2026-04-29 Add Playwright E2E test suite with mock BLE transport
    - 10 smoke tests covering nav, connect flow, action tiles, disconnect state
    - Mock injects a fake GATT/NUS stack via addInitScript so tests run without
    hardware; handles all JSON-framed protocol ops (ping, script.list, action.list/invoke)
    - playwright.config.ts auto-detects system Chrome (NixOS nix-profile path)
    - Fix: default script template in Scripts view now shows setup()/teardown()
    pattern instead of deprecated loop()
    - Fix: Event.target is read-only — mock uses plain object instead of Event
2026-04-30 feat: Add log streaming and signal watch to Dashboard
    Berry print() is now overridden by a C binding that pushes
    {"type":"log","msg":"..."} frames over BLE; the Protocol client
    dispatches them via onLog(). Dashboard shows a scrollable log panel.
    A new signal.value protocol op reads can_signal() state on demand.
    Dashboard polls watched signals every 1 s; signal names are persisted
    to localStorage.
2026-04-30 examples: add hello_log.be, migrate loopback_led off loop()
    hello_log.be exercises the new Dashboard log panel and action tile
    plumbing without needing CAN traffic. loopback_led.be was still using
    the deprecated loop() global; rewrite it as setup() + timer_every.
2026-04-30 webui: harden Load Example dropdown against bind feedback loops
    The previous version used bind:value plus an onchange handler that
    reset the bound value, which (under Svelte 5 reactivity) could fire
    the change handler again with an empty value. Switch to a plain
    onchange that reads e.currentTarget.value and resets the DOM directly,
    removing the round-trip through state.
2026-04-30 webui: signal autocomplete + per-row bus + error tooltip in Watch
    Loaded DBC signals now flow through a small reactive store
    (dbcStore). The Dashboard signal-watch input gets a <datalist> for
    autocomplete and a per-row bus selector, defaulted to whichever bus
    the DBC was last uploaded to. Errors from signal.value calls show
    their actual message inline and as a tooltip instead of just "error".
2026-04-30 firmware: surface loop() deprecation warning to UI log panel
    berry_log_push() lets non-Berry code emit a line through the same
    push channel that Berry print() uses, so the script loader's warning
    about a deprecated loop() global now appears in the Dashboard log
    panel — not just on the serial console where users won't see it.
2026-04-30 tools: add Berry parse-check for example scripts
    scripts/parse_check_examples.sh builds a small native parse-checker
    against the bundled Berry sources and runs it over every .be in
    scripts_examples/. Catches syntax errors, malformed expressions, and
    references to globals that aren't on our binding list — all without
    flashing to a device.
    Berry's strict-globals compile pass requires every binding name to be
    visible at parse time, so parse_check.c pre-declares every binding we
    expose at runtime as a nil global. The list must stay in sync with
    be_regfunc() calls in src/scripting/berry_bindings.c.
2026-04-30 firmware: hook Berry log streaming via be_writebuffer
    The earlier approach registered a global called print and assumed it
    would shadow Berry's built-in. It doesn't — Berry compiles print()
    references directly to the built-in opcode, so the global override
    never fires and nothing reached the Dashboard log panel.
    Move the log handler into the Berry port layer where be_writebuffer
    already sees every character that built-in print() writes. The handler
    is set from protocol_init exactly as before; trailing newlines are
    trimmed so each push frame is a clean line.
2026-05-01 fix: reduce serial log noise and avoid redundant script.list calls
    - Suppress NimBLE per-notify INFO logs (set to WARN level)
    - Log "Enabled: <script>" before setup() so Berry print output follows it
    - Log script.write result with file count
    - Webui: optimistic enable/disable/delete updates avoid a round-trip script.list
2026-05-01 fix: move CAN tx/rx logs to DEBUG and fix Berry list subscript in examples
    can_driver: tx/rx now log at LOGD (silent by default, enable with
    idf.py -DLOG_LOCAL_LEVEL=ESP_LOG_DEBUG or esp_log_level_set).
    bench_test / loopback_led: rx[0]/rx[1] → rx.item(0)/rx.item(1).
    Berry BE_LIST is not a VM instance so the GETIDX opcode doesn't
    dispatch item() — must call it directly.
    [can_driver.c]
2026-05-01 fix: add per-bus RX ring buffer so Berry can_receive() sees polled frames
    can_poll() drained the TWAI hardware queue before berry_timer_tick() ran,
    so can_receive() always returned nil (loopback LED always red).
    can_poll() now pushes every received frame into a per-bus software ring
    buffer (depth 16). can_rx_pop() pops from it. l_can_receive() uses
    can_rx_pop() instead of reading TWAI directly, so Berry scripts see all
    frames that arrived since the last timer tick regardless of poll ordering.
    Also lower heap/tick log from every 1s to every 10s.
    [can.c, can.h, main.c]
2026-05-01 fix: move BLE dispatch to main task to eliminate Berry VM race
    The NimBLE task (gatt_access_cb) called dispatch_frame() directly,
    which ran script_loader_enable/disable and accessed the Berry VM.
    On ESP32-C6 (single-core) the NimBLE task can preempt the main task
    mid-berry_timer_tick(), corrupting VM state and causing hangs/timeouts.
    protocol_on_ble_write() now only reassembles frames and enqueues them
    via a FreeRTOS queue. protocol_tick() (called at the top of the main
    loop) drains the queue and dispatches, keeping all Berry VM access on
    the main task.
    [main.c]
2026-05-01 feat: persist script enabled state across reboots
    Adds script_loader_save_enabled() / script_loader_restore_enabled().
    Save writes SCRIPT_DIR/.enabled (one filename per line) whenever the
    user enables or disables a script via the protocol. Restore reads that
    file at boot (after scan) and re-enables only the listed scripts, so
    the set of running scripts survives power cycles.
    [main.c]
2026-05-01 fix: rate-limit blue LED blink and turn off RGB on loopback script disable
    Blue LED: only trigger a 50ms pulse at most once per 200ms so it blinks
    visibly (~5 Hz) rather than flickering at the frame rate.
    loopback_led: add teardown() calling led_off() so the RGB LED turns off
    when the script is disabled instead of staying on in its last colour.
    [main.c]
2026-05-01 feat: add disable-all / enable-all master toggle to script list
    A checkbox in the list header disables all enabled scripts when
    unchecked and enables all disabled scripts when checked. Label text
    tracks current state ('disable all' vs 'enable all').
2026-05-04 Fix LittleFS partition subtype
    [partitions.csv]
2026-05-04 fix: set flash size to 4MB to match ESP32-C6-SuperMini hardware
    ESP-IDF's Kconfig defaults ESPTOOLPY_FLASHSIZE to 2MB regardless of
    target, causing a mismatch warning when PlatformIO's board definition
    (correctly) specifies 4MB.
2026-05-04 chore: ignore hardware/case/export/ directory
2026-05-04 test: native test for per-ID TX rate limiter
    Covers default rate, per-ID overrides (tighter and looser), independent
    slots per id, table overflow, and the 0-Hz "unlimited" mode. Six cases,
    runs against the real rate_limit.c.
2026-05-04 refactor: extract length-prefixed framing into reusable helper
    protocol.c had the BLE rx framing (4-byte LE length prefix + payload)
    inlined as buffered bytes plus a drain loop. Pulled it out into
    frame_buf_t so it can be unit-tested and reused by a future WebSocket
    transport.
    Includes seven host tests covering BLE chunking corner cases: a frame
    in one append, one byte at a time, multiple frames in one append, the
    zero-length case, oversized length prefix, append overflow, and a
    consume() with no preceding peek.
2026-05-04 feat: simulation mode toggle from the UI
    can_set_sim_mode existed on the firmware side but had no way to be
    flipped at runtime. Add a sim.set op (with an optional bus filter)
    plus a checkbox strip on the Dashboard. When ON, every can_send is
    routed to the log instead of the bus — useful for developing scripts
    without being in the car.
2026-05-04 feat: live CAN trace view
    A first-class reverse-engineering tool: the firmware streams every
    received frame on subscribed buses, the UI renders them with id/bus
    filtering, pause, clear, and candump-format export.
    Firmware:
    - can_set_raw_observer() hook in can.c, called from can_poll() once
    per received frame on either bus.
    - protocol.c handles trace.start { buses: [0,1] } and trace.stop,
    pushes { type:"trace", bus, id, ts, data:hex } notifications.
    Auto-suppresses if no client is connected.
    WebUI:
    - Protocol.onTrace + traceStart/traceStop methods.
    - New Trace.svelte view with bus checkboxes, id filter (hex
    substring), pause/resume, clear, export. Frames are batched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
2026-05-05 feat: signal subscribe/push replaces 1 Hz polling on Dashboard
    Signal Watch was hammering the BLE link with one signal.value RPC per
    entry per second. Replace it with a subscribe model: the firmware pushes
    a {type:"signal"} frame on every decoded value change for subscribed
    (bus, name) pairs.
    Firmware (protocol.c):
    - signal.subscribe { name, bus } registers a can_on_change callback
    using a unique tag (SIG_SUB_TAG_BASE | slot) outside the script-id
    range, so berry_cleanup_script never touches it.
    - signal.unsubscribe { name?, bus? } removes one entry, or all if no
    name is given.
    - Idempotent re-subscribe; up to 16 active subscriptions.
    - Protocol gains subscribeSi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
2026-05-05 feat: add Settings view; move sim toggle and add kill-all-scripts
    The sim mode toggle was squatting on Dashboard. Promote it to a proper
    Settings tab next to firmware/protocol info and a global "disable all
    scripts" kill switch.
    - New Settings.svelte: device info (fw_version, proto_version), sim
    mode toggle, kill switch (lists scripts and disables each enabled
    one with a confirm dialog).
    - Removed sim strip from Dashboard.
    - Updated Playwright smoke to find the toggle in Settings and assert
    the fw version is rendered there.
2026-05-05 feat: load exported trace files in the Trace view
    Adds a Load button that imports a previously exported .log file (the
    candump-ish format the Export button produces) and shows the captured
    frames in the same table as live trace. Lets you review past captures
    or share them between users without firmware involvement.
    Replay-to-bus (re-transmitting frames over CAN) is a separate feature
    and would need a firmware op; deferred.
2026-05-05 feat: Monaco editor in Scripts view with Berry tokenizer + completions
    Replaces the textarea with a real code editor. Provides syntax
    highlighting, autocompletion of every binding the firmware exposes
    (can_send, can_on, timer_*, action_register, etc.), and hover docs
    for each.
    Implementation notes:
    - Imports from `monaco-editor/esm/vs/editor/editor.api` rather than
    the umbrella entry to avoid pulling all built-in languages
    (~3 MB → 2.6 MB raw, 928 KB → 678 KB gzipped).
    - Worker wired up via Vite's ?worker import for editor.worker.
    - registerBerry() is idempotent so multiple editors share one
    language registration.
    - The API list mirrors be_regfunc() calls in berry_bi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
2026-05-05 feat: WiFi STA bringup + wifi.{status,set_creds} ops + Settings UI
    First half of Phase 2.1 — get the device on a network. Second half (HTTP
    + WebSocket transport, refactor protocol routing) is a separate session.
    - New wifi/wifi.{h,c}: STA-only; reads creds from NVS namespace 'wifi',
    auto-reconnects with a 5 s backoff. If no creds stored, the driver
    starts but stays idle until wifi_set_creds() is called.
    - wifi_init() runs from main.c after fs_init() (BT and WiFi coexist on
    ESP32-C6 via CONFIG_ESP_COEX_SW_COEXIST_ENABLE).
    - sdkconfig.defaults: enable WiFi + coex.
    - protocol.c: wifi.status returns {connected, ssid, ip}; wifi.set_creds
    persists and reconnec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
2026-05-05 chore: grow OTA partitions to 1.75 MB; shrink LittleFS to 448 KB
    Adding WiFi pushed the firmware to 93.5% of the 1.5 MB OTA slot — too
    close to the ceiling for HTTP server + WebSocket to land. Reclaim
    512 KB from LittleFS (we only use ~150 KB for scripts + DBCs) and split
    it across the two OTA partitions.
    Math (4 MB flash, ~64 KB reserved for bootloader/nvs/ota/phy):
    app0 : 1.5 MB → 1.75 MB
    app1 : 1.5 MB → 1.75 MB
    littlefs: 960 KB → 448 KB
    Firmware utilization drops 93.5% → 80.2%.
    Heads-up: shrinking LittleFS reformats it on the next flash, so saved
    scripts, uploaded DBCs, and the .enabled persistence file are wiped.
    One-time cost.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
    [partitions.csv]
2026-05-05 fix: signal.subscribe panic when target bus has no DBC loaded
    handle_signal_subscribe called dbc_find_signal directly, which
    dereferences dbc->hdr without a null check. On a device with only
    bus 0 DBC loaded, any watched signal saved against bus 1 (e.g. by
    mistake or because the DBC was uploaded later to a different bus)
    triggered a load access fault on the next Dashboard mount when the
    UI replayed its localStorage subscriptions.
    Two-layer fix:
    - protocol.c: gate handle_signal_subscribe on eng->loaded and
    return a useful "no DBC loaded for bus" error, matching the
    pattern handle_signal_value already follows.
    - dbc_pack.c: dbc_find_signal now bails on dbc/hdr/sigs null,
    makin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
2026-05-05 chore: production log strip + panic-decode helper script
    Two related dev-loop improvements.
    1. Per-env log level via sdkconfig overlay
    - sdkconfig.defaults.release: CONFIG_LOG_MAXIMUM_LEVEL_ERROR + matching
    default. Wired into [env:esp32-c6] via board_build.cmake_extra_args
    so it stacks on top of the baseline sdkconfig.defaults.
    - [env:esp32-c6-debug] explicitly drops the overlay (debug env extends
    production but DEBUG-level was too noisy; INFO is the target).
    - Compile-strip removes ~44 KB of rodata format strings — production
    drops 80.2% → 77.8% of the OTA partition.
    - .gitignore now keeps `sdkconfig.defaults.*` overlays alongside the
    base defaults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
2026-05-05 test: regression — dbc_find_signal must be null-safe
    Locks in the fix for the Guru Meditation panic that fired when signal.subscribe
    landed before any DBC was loaded. dbc_find_signal previously dereferenced
    hdr->sig_count on a zero-initialized dbc_t.
2026-05-05 test: device smoke runner with auto panic decoding
    scripts/device_smoke.sh flashes the firmware, captures serial output for a
    fixed window (default 30s), and exits non-zero if it sees a panic, boot loop,
    or no log output at all. On panic, pipes the dump through decode_panic.sh
    so the failing source line is in the same console output.
    Closes the loop where I had to ask the user to flash, monitor, and paste
    back any crash. With this I can run a smoke after each firmware change and
    catch regressions on my own.
    Note: requires the serial port to be free — close any IDE serial monitor
    or pio device monitor session before running.
2026-05-05 test: pure-Node protocol round-trip suite
    Adds tests/protocol-roundtrip.spec.ts that wires the real Protocol class to
    a fake Transport whose send/receive end speaks the same 4-byte-LE-length +
    JSON wire format the firmware does. 13 cases cover:
    - request/response id correlation
    - error responses propagate as rejection
    - params serialize into the request body
    - large payloads survive the chunked send loop
    - push frames (signal, log, trace) fire the right callback with correct shape
    - subscribe → push → unsubscribe lifecycle
    - unsolicited responses don't break the queue
    - two frames in one chunk both deliver
    - one frame split byte-by-byte reassembles
    Why this matters: u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
2026-05-05 test: top-level make test runner + pre-commit hook
    - Makefile at repo root: `make test` runs firmware native tests + webui
    Playwright suite (~13s, no device, no browser window). `make test-device`
    flashes and smokes the connected board.
    - scripts/git-hooks/pre-commit: runs the relevant subset based on staged
    paths so unrelated commits stay fast. Bypassable with --no-verify.
    - scripts/setup-hooks.sh: one-command opt-in (sets core.hooksPath).
    - device_smoke.sh: replaced `pio device monitor` with a direct pyserial
    read because pio's monitor calls termios on stdin and crashes when stdin
    isn't a TTY. Picks up PlatformIO's bundled python automatically (it
    always has pyserial).
    Co-Auth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
2026-05-06 ci: webui workflow — type check + Playwright tests
    Adds a GitHub Actions job that runs svelte-check, tsc, and the full
    Playwright suite (UI smoke + protocol round-trip) on any change under
    webui/. Caches both npm and the ~150 MB Playwright Chromium download so
    warm runs are <1 min.
    Mirrors the structure of firmware.yml (separate workflow, paths-filtered)
    so a webui regression doesn't block firmware CI and vice versa.
2026-05-06 Berry CAN API — new naming hierarchy (can_<level>_<verb>):
    raw frame: can_send_raw(bus, id, bytes), can_recv_raw(bus) — symmetric pair
    message: can_msg_get(id [,bus]), can_msg_set(draft, sig, val), can_msg_send(draft)
    signal: can_signal_get(msg, sig [,bus]), can_signal_on(msg, sig, fn [,bus]) — scoped by message name
    Real ambiguity fix in C (you picked the harder option):
    New dbc_find_signal_in_msg(), dbc_find_msg_by_name(), dbc_find_signal_by_msg_name() in dbc_pack.c with 3 new native tests.
    New can_on_change_scoped() and can_signal_scoped() in can.c used by the Berry bindings.
    can_msg_set now scopes its signal lookup to the draft's message id — fixes a latent collision bug.
    Protoc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
    [can.c, can.h]
2026-05-06 feat(webui-v1): new Svelte UI ported from design bundle, wired to BLE
    Parallel directory to webui/ — left rail + status strip + 11 views, all
    wired to the existing Protocol/BleTransport.
    Reused from webui/: transport (ble.ts, protocol.ts), dbc/parser.ts,
    dbcStore, editor (real Monaco with Berry highlighter).
    Wired views:
    - Events: action.list / action.invoke
    - Scripts: script.list/read/write/enable/disable/delete + Monaco
    - Trace: trace.start/stop + onTrace push, 20Hz flush, CSV/candump export
    - Dashboard: signal.subscribe + onSignal push, sparkline, localStorage
    - DBC: parseDbc/compileDbc + transport.send, populates dbcStore
    - Settings: wifi.status/set_creds, system.info, sim status
    St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
2026-05-06 style(webui-v1): Monaco theme matches Kimbie warm palette
    Re-themed in monaco-setup.ts so the editor stops fighting the
    surrounding chrome — warm orange keywords, amber strings, brown
    surfaces, and the bracket-match / suggest-widget colors all draw
    from the same --dc-* tokens used elsewhere.
2026-05-06 feat(webui-v1): example-script picker in Scripts view
    'Load example…' select sits between New and Import. Sourced from
    firmware/scripts_examples/*.be via Vite's import.meta.glob (compile-time
    inline, no runtime fetch). Picking one drops the example into the
    editor as an unsaved draft — user sets a filename and Saves.
2026-05-06 fix(webui-v1): drop dbc filename column from car picker
    Rows now show: model · years · popular-tag · check. Filename was
    extra noise — users pick a vehicle, the firmware handles the dbc.
2026-05-06 feat(webui-v1): split gallery DBCs (opendbc/community), wire load to DBC view
    - sampleData GalleryDbc gains source: 'opendbc' | 'community'; only the
    Tesla Model 3 vehicle DBC has a bundled url for now (others would need
    to be fetched from their respective repos at build time).
    - Gallery DBC tab renders two sections with subhead + headers; community
    cards drop the opendbc link and show the bare filename.
    - Each card has a per-card bus picker (defaults to the card's bus). Load
    button sets app.pendingDbc and switches to the DBC view.
    - DbcView watches app.pendingDbc, fetches the URL, parses, switches bus
    tab, uploads if connected; clears the flag.
    - Store gains pendingDbc + loadedDbc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
2026-05-06 feat(webui-v1): bus pips show (dbc) link when a DBC is loaded
    Each BusPip now reads app.loadedDbc[id]; when populated, renders a
    small dotted-underline (dbc) link. Click navigates to the DBC view
    and selects that bus tab via a new app.dbcViewBus navigation field
    (separate from pendingDbc which fetches+uploads).
    DbcView watches dbcViewBus and switches its bus tab.
2026-05-06 ui(webui-v1): tooltip CSV vs candump export
    CSV: spreadsheet-friendly columns (ts_ms, bus, id_hex, dlc, data_hex).
    candump: Linux can-utils log format, replayable via canplayer or by
    re-loading into Trace.
2026-05-06 ui(webui-v1): simpler T silhouette for Tesla-BLE rail icon
    Replaces the previous abstract glyph with a basic T mark (top crossbar
    + end-drops + center stem) that reads better at 20px and matches the
    "Tesla-BLE" label.
2026-05-06 fix(webui-v1): rail never scrolls horizontally
    Explicit overflow-x: hidden on .rail__list. Vertical scroll only.
2026-05-06 fix(webui-v1): drop decorative green LED on status-strip left edge
    Competed with the transport pip's actual connection dot. Strip is just
    the chassis band now — pips on it carry the state.
2026-05-06 feat(webui-v1): confirm before clobbering, Ctrl+S saves in Monaco
    - ScriptsView's pendingExample $effect now confirms before overwriting
    an unsaved buffer (so the Add-event tile flow doesn't lose work).
    - MonacoEditor exposes an onSave prop and binds Cmd/Ctrl+S to it,
    swallowing the browser's "save page" dialog.
    - ScriptsView passes its save() handler through.
2026-05-06 fix(webui-v1): kill switch refreshes Scripts; release restores enabled set
    Store remembers the filenames it disabled when Kill engages and re-enables
    that set on Release. Bumps app.scriptsVersion on each transition so
    ScriptsView's $effect re-fetches script.list and the row toggles redraw.
2026-05-06 docs(webui-v1): TODO note on firmware-side LED wiring for event tiles
    Tile LED indicator is decorative until the Berry runtime can publish
    per-action status — sketches two viable contracts (extend action.list
    or new push topic) so the UI side is ready when firmware adds it.
2026-05-06 Update script status live during kill switch
2026-05-06 Switch script editor to CodeMirror
2026-05-07 Revert "style(webui-v1): tile compactness — content-height rows, smaller icon"
    This reverts commit a2efd00070518952edef8b7edc4afacf2d9c7ddb.
2026-05-11 ota: persistent reboot-after-update toggle + clearer streamFirmware contract
    The reboot-after-update toggle used to only appear inside the System
    power button while otaBusy=true. Replace it with a dedicated checkbox
    that's always editable so the user can set the policy before kicking
    off the upload. System power becomes a plain reboot button again.
    Rename Protocol.uploadFirmware -> streamFirmware to reflect that it
    streams chunks but does NOT call ota.end; the caller composes begin +
    write + end so it can read the live reboot flag right before commit.
    Drop the redundant otaTotal=total reassignment inside the progress
    callback (set once from bin.length before the loop).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
2026-05-11 ota: binary chunk frames over BLE (no base64, no JSON)
    Repurpose the top nibble of the existing 4-byte length header as a
    frame-type discriminator (0 = JSON, 1 = OTA_WRITE binary). Bottom 28
    bits are still the payload length, so legacy JSON frames remain
    bit-compatible with the old format.
    A binary ota.write frame body is u32 LE id + raw firmware bytes. The
    firmware dispatcher hands it straight to ota_write — no cJSON_Parse,
    no base64 decode, no allocation. The response is still JSON {ok,id}
    so the client reuses its existing pending-promise machinery.
    This drops the ~33% base64 inflation on every OTA chunk plus the
    matching parse/decode cost on the device. Combined with the existing
    ~4 K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
2026-05-11 release: build-flag for version + tag-based prerelease gating
    Replace the sed-rewrite of platformio.ini with PLATFORMIO_BUILD_FLAGS
    (appended to the env's build_flags, overrides the baked default).
    Immune to whitespace and formatting changes in the ini file.
    Gate the GitHub release's prerelease flag on the tag: plain semver
    (v1.2.3) ships as stable, anything with a hyphen after the version
    (v1.2.3-rc1, v1.2.3-beta.2, …) ships as a pre-release. Was hard-coded
    to true previously, so there was no path to a real stable release.
    Also drop the duplicate firmware.bin upload — the renamed
    dorky-commander-<version>.bin is the only artifact now.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
2026-05-11 ota: drop legacy JSON ota.write path
    The binary frame path supersedes it and there's no longer any client
    that emits the base64-in-JSON form. Removing the handler also lets us
    drop the 5 KB s_ota_chunk_buf static (-5120 B RAM) and the mbedtls
    component requirement; mbedtls itself stays linked via esp_wifi but no
    direct dependency from src/ remains.
    Net: -5120 B RAM, -304 B flash.
2026-05-11 ota: log running partition + state on boot
    After a successful BLE OTA + reboot the device should come back on the
    other slot. Without a print there's no easy way to confirm the swap.
    ota_log_boot_info() logs the running partition's label, address, size,
    and OTA state (valid / pending-verify / etc), plus the next OTA slot
    that the following update would land in. Called from app_main right
    after the version banner.
    [main.c]
2026-05-11 fix(webui): use BASE_URL for default DBC fetch
    Hardcoded /dbc/... paths 404'd on GitHub Pages where the site lives
    under /ESP32-DualCAN/. Vite injects import.meta.env.BASE_URL, which
    is '/' in dev and the configured base in production builds.
2026-05-11 webui: replace favicon with the rail brand mark
    Mirrors the inline SVG from Rail.svelte so the browser tab matches
    the corner logo. Colors are inlined (favicons can't resolve CSS vars).
2026-05-11 moved buttons
2026-05-11 webui: improve firmware update UX
    - Firmware status pip now navigates to settings and scrolls to firmware frame
    - Consolidate firmware update methods (file + GitHub) on single row
    - Version indicator shows three states: green (latest), amber (update available), red (protocol mismatch)
    - Check GitHub for latest stable release (non-RC) on connect
    - Fall back to manual download if CDN fetch blocked by CORS (dev server)
2026-05-11 webui: add direct download link for GitHub releases
    Provide manual download button as fallback when automatic download fails due to CDN CORS restrictions. Users can download the .bin directly, then upload via file picker.
2026-05-11 fix(sim): route can_send_raw TX to webui log in sim mode
    can_send_raw was calling can_bus_send directly, bypassing the sim_mode
    check entirely. Now checks the flag and pushes a formatted log line via
    berry_log_push so simulated sends appear in the webui device log panel.
2026-05-11 webui: use bolt icon for Events and move DBC after Scripts in nav
2026-05-11 perf(dbc): lazy-render signal rows + defer parse off main thread
    Signal <ul> rows are now only rendered when a message <details> is
    expanded (via ontoggle + openMessages Set), so initial mount only
    creates ~50 DOM nodes instead of all signals at once.
    loadText() now yields via setTimeout(0) before calling parseDbc() so
    the "Parsing…" status paints before the CPU-bound work runs.
2026-05-11 fix(nav): add touch-action: manipulation to rail buttons
    On iOS, buttons inside overflow-x: auto containers can have their
    click swallowed when a horizontal scroll gesture is detected on
    touchstart. Adding touch-action: manipulation tells the browser to
    treat the touch as a tap, not a scroll, so onclick fires reliably.
    Also eliminates the 300ms tap delay on mobile.
2026-05-11 webui: pointer-event resize handles + mobile scripts min-height
    - Switch splitter and editor corner from mousedown to Pointer Events API
    so drag-resize works on touch devices as well as mouse
    - setPointerCapture keeps the drag live when pointer leaves the element
    - touch-action: none on both handles prevents scroll interference
    - Remove {#if !isMobile} guards; handles now render on all screen sizes
    - Enlarge editor corner to 20px for easier touch target
    - Add min-height: 85px to scripts panel on mobile (shows ~1.5 rows)
2026-05-11 webui: align title/filename min-width to scripts column; fix button wrap
    - SectionHead title div: min-width 240px to align with scripts column
    - Filename input: min-width 160px, max-width 280px
    - Editor frame head: flex-wrap so buttons drop below filename on narrow screens
    - Buttons span: flex-shrink:0 + flex-wrap to prevent overlap
2026-05-12 chore(roadmap): drop WiFi HTTP server from Phase 2, add PWA install
    Replace the WiFi/HTTP server + WebSocket transport adapter tasks with a
    PWA "install as app" entry. Users pin the GH Pages web app to their home
    screen or desktop rather than serving the UI from the device.
2026-05-12 feat(webui): PWA — manifest, service worker, install button in Settings
    - manifest.json: name/short_name, standalone display, Kimbie theme color, SVG icon
    - sw.js: network-first navigation + cache-first assets; enables install prompt
    - index.html: <link rel="manifest">, apple-touch-icon, Apple standalone meta tags
    - main.ts: register SW on startup
    - store: capture beforeinstallprompt → installApp(); isInstalled detection
    - SettingsView: "Install app" section shown only when prompt available and not already installed
2026-05-12 feat(webui): baseline diff and event-triggered capture in CaptureView
    Baseline diff: polls every DBC signal via signal.value, records two
    snapshots (A/B), shows a table of changed signals sorted by |Δ|.
    Event capture: arms on a signal condition (polled at 500 ms), auto-starts
    trace on trigger, stops after configurable duration, stores frames and
    offers CSV/candump export. Auto-disarms on disconnect or unmount.
    Replay stub kept but clearly labelled as needing a firmware can.send op.
2026-05-12 feat(webui): merge signal watch into Dashboard; rename dashboard→signals
    - EventsView renamed to DashboardView — now hosts both event tiles and
    live signal watch (stacked sections, shared scroll wrapper)
    - Old DashboardView replaced by SignalsView — placeholder for future plotting
    - Nav: 'Events' → 'Dashboard', 'Dashboard' → 'Signals'
    - ViewId: 'dashboard' → 'signals'
    - CSS: .events-scroll wrapper takes over scroll so evgrid no longer flex-grows
    fix(webui): stage merged DashboardView content missed by git mv
2026-05-12 fix(pio): remove monitor_rts/dtr=0 — causes BLE disconnect on C6 USB-JTAG
    Actively driving DTR/RTS low when the serial monitor opens triggers a
    reset on the ESP32-C6's built-in USB-Serial-JTAG controller, dropping
    BLE connections. Leaving them unset lets pyserial open the port without
    touching the lines.
2026-05-12 test(webui): unit tests for evalCond and computeDiff (capture logic)
    Extract evalCond + computeDiff from CaptureView into src/lib/capture.ts
    so they can be tested standalone. Add capture.test.ts: 13 tests covering
    all 6 condition operators (including epsilon, negatives) and diff row
    filtering, delta sign, sort order, and null-skip behaviour.
    Total webui tests: 27 (was 14).
2026-05-12 webui: show 'dev' state in version pip for commit-hash builds
    Detect non-release firmware (short hash ± -dirty) and show a neutral
    dim LED + 'dev' label instead of misleading 'latest'/'update'.
2026-05-12 feat(webui): wire gallery scripts to real .be files with Preview/Install
    Replace fake placeholder GALLERY_SCRIPTS with entries linked to actual
    firmware/scripts_examples/ files. Preview toggles inline code display.
    Install loads the bundled script content into the Scripts editor via
    pendingExample (same path as the event-tile flow).
2026-05-12 feat(webui): persist AI key + model to localStorage, wire Settings inputs
    store: aiKey/aiModel $state loaded from localStorage on init; setAiKey()
    and setAiModel() keep state + storage in sync.
    Settings: key input and model select now bound to store; status row shows
    "key set · model" or "no key" live. Model options updated to real IDs
    (haiku-4-5-20251001, sonnet-4-6).
2026-05-12 feat(webui): AI assistant — streaming Claude API, code-block install
    Replace mock setTimeout with real streaming Anthropic API calls:
    - fetch with anthropic-dangerous-direct-browser-access header (BYOK)
    - SSE parsing: content_block_delta text chunks accumulate live
    - Multi-turn history maintained for context across messages
    - System prompt includes Berry API reference, loaded DBC signals,
    3 bundled example scripts
    - Response segments split into prose and code blocks
    - Berry code blocks rendered as script cards with Install only /
    Install & enable buttons (writeScript + enableScript)
    - Status pill shows key set / model; links to Settings if no key
    - Blinking cursor while streaming; erro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
2026-05-12 docs(firmware): user-facing README — flash, connect, first script, OTA
    Covers the Phase 3 exit criterion: a new user can flash the prebuilt
    binary, open the GH Pages UI, pair over BLE, load a DBC, enable an
    example script, and use OTA updates — with only this README.
    Sections: prerequisites, flash (prebuilt + build-from-source), BLE
    connect, DBC load, first script, action tiles, Berry API reference table,
    OTA update, troubleshooting, dev commands.
2026-05-12 fix(scripts): turn off LED on teardown in loopback_led
2026-05-12 fix(webui): improve AI system prompt Berry CAN context
    - on_can_signal arg order now explicit: (message_name, signal_name, fn)
    - DBC signal list reformatted as "signal (message: msg_name)" to make
    arg mapping unambiguous
    - bytes API documented: add/set/item
    - Missing bindings added: state_remove, action_invoke, action_list
    - Script metadata convention shown: @name, @description, @bus
    - API grouped into clear sections (CAN signals, raw frames, encoded,
    timers, actions, LED, storage, utilities)
    - Signal cap raised 60→80; instruction to use exact names from list
2026-05-12 feat(webui): attach existing scripts to AI for editing
    Two entry points:
    - Scripts view: "Ask AI" button sends current editor content + filename
    to AIView via pendingAiScript store hand-off.
    - AIView: "📎 Attach script" button lists device scripts, loads selected
    one via readScript(), shows dismissable badge above textarea.
    On send, attached script is prepended to the API message as a berry code
    block for context; the chat bubble shows just the user's words + a small
    "📎 filename.be" indicator. Install & enable overwrites the same filename
    so edits land back on the right script.
2026-05-12 feat(webui): move 📎 AI button into editor header, left of Save
    Rename "Ask AI" → "📎 AI", relocate from the section header to the
    editor toolbar so it sits next to Save / Save & enable. Button row
    already has flex-wrap so it wraps below the filename+unsaved span
    on narrow screens without overlapping.
2026-05-12 fix(webui): script editor two-row header; attach button above AI prompt
    ScriptsView: change editor frame__head to flex-direction:column so
    filename row and button row are always stacked — buttons can never
    overlap the filename input or unsaved indicator.
    AIView: move "Attach script" button above the textarea; it's hidden
    once a script is attached (replaced by the badge) or the picker is
    open, so the three states (attach btn / picker / badge) are mutually
    exclusive in the same slot.
2026-05-12 fix(webui): script editor header wraps without overlap
    Replace two-row column layout with single-row that wraps correctly.
    Root cause: frame__head has justify-content:space-between in CSS, and
    flex:1 on the filename span made it always fill remaining space so
    buttons never had a chance to wrap.
    Fix: give filename span a fixed width (not flex:1) and use margin-left:auto
    on the button span — same space-between visual when wide, but buttons
    wrap to the next line cleanly when the panel is narrow.
2026-05-12 fix(webui): buttons stay on top when header wraps; clean up AI button
    flex-wrap:wrap-reverse on editor header: items still flow left→right
    on each line, but overflow lines appear ABOVE the current line. So when
    there isn't enough room for both, buttons wrap upward and filename stays
    below — not the other way around.
    AI button: drop the redundant sparkle SVG (was paired with 📎 emoji),
    keep just "📎 AI" which is more readable at small sizes.
2026-05-12 fix(webui): remove filename input from editor header; lower sparkle icon
    ScriptsView: drop the filename <input> from the editor panel header —
    editorFilename state is still used internally for save/AI hand-off,
    just not rendered. Header now shows only the ● unsaved indicator + the
    button row, which wraps cleanly without overlap concerns.
    icons: shift sparkle paths down +6 (y: 4→10 top, 16→22 bottom) so the
    star fills the lower half of the 24×24 grid rather than floating near
    the top.
2026-05-12 fix(webui): center sparkle icon in 24×24 grid
    Main star center y: 16→12; spans 6→18. Small star center y: 12→8;
    spans 6→10. Both paths centered on the midpoint of the viewBox.
2026-05-12 refactor(webui): route script status messages to log panel
    Drop local status state and the inline status bar below the editor.
    All script operations (save, enable, disable, delete, import, error)
    now call app.pushLog(..., 'scripts') so feedback appears in the log
    pane alongside device output.
2026-05-12 docs: add SCRIPTING.md at repo root; wire into AI system prompt
    SCRIPTING.md is the single source of truth for the Berry scripting API —
    human-readable markdown served on GitHub, and imported at Vite build time
    via SCRIPTING.md?raw into the AI assistant system prompt. Eliminates the
    ~80-line inline API block that was duplicated in AIView.svelte.
    firmware/README.md: links to ../SCRIPTING.md for the full reference.
    AIView: drops the examples import (examples are now in SCRIPTING.md).
    docs(readme): link to firmware/README.md and SCRIPTING.md from root
2026-05-12 feat: store Anthropic API key in device NVS, load on connect
    Adds a generic named-secret API to the firmware (settings.set_secret,
    get_secret, has_secret, clear_secret) stored in NVS namespace "secrets".
    UI saves the key to device NVS and loads it back into the browser on
    every BLE connect, so the key only needs to be entered once.
    Bumps proto_version to 2 to surface incompatibility with older firmware.
2026-05-12 fix(webui): red LED + warning label for protocol incompatibility
    Adds missing pip__led--err CSS (red glow), renames sentinel value from
    'incompatible' to 'warning', and expands the proto mismatch notice in
    Settings into a red error card with a link to the Firmware section.
2026-05-12 feat(ble): keep advertising while connected; newest connection wins
    Always re-advertise after a connect (via ble_npl_callout deferred 200ms
    to let HCI settle) so a second device can always see and connect to the
    device. On connect, terminate any existing connection first so the
    incoming client immediately takes over. Raise BT_NIMBLE_MAX_CONNECTIONS
    to 2 so the controller allows connectable advertising while one link is
    active.
2026-05-12 fix(webui): suppress browser autofill on API key input
    Switch to type=text/password toggle with show/hide button so Chrome
    doesn't classify the field as a credential target. Keeps autocomplete=new-password
    as a secondary hint.
2026-05-13 feat(ble): persist BLE bonds across reboots via NVS
    Enables CONFIG_BT_NIMBLE_NVS_PERSIST so NimBLE stores bond keys in NVS
    automatically. Paired devices reconnect without re-pairing after reboot.
    Max bonds already set to 3.
2026-05-13 Add platform.ts: isMac/isTouch/modKey constants. StatusStrip shortcut button hidden on touch devices; shows ⌘K on Mac and Ctrl+K on Windows/Linux. Rail tooltip matches.
2026-05-15 fix(webui): bus pips now light up from any push frame, not just TraceView
    Move bus activity tracking into Protocol so trace and signal frames both
    tick the status-bar pips regardless of which view is active.
2026-05-16 feat(can): bus health detection with bitrate-mismatch diagnostics
    Push a 5-state bus health (idle / good / tx_error / rx_error / error)
    to the webui so StatusStrip can show why a bus isn't delivering frames
    instead of just "no traffic".
    Key trick: a GPIO negedge ISR on the RX pin distinguishes "bus is
    dead" (no electrical edges) from "bus is alive but we can't decode"
    (edges without valid TWAI frames — usually wrong bitrate or format).
    The ISR self-disables after the first edge to avoid flooding, and is
    re-armed each health-check tick.
    TX_ERR vs RX_ERR is resolved with tx_error_counter: edges with no
    frames AND TX errors → we're the only talker, nobody ACKs (TX_ERR);
    otherwise → some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
    [can.c, can.h, can_driver.c, can_driver.h, test_loopback.cpp]
2026-05-16 refactor(scripts): replace hand-rolled confirm dialog with bits-ui AlertDialog
    Adds focus trap, scroll lock, Escape-to-close, aria-labelledby/describedby,
    and focus restoration. Uses onOpenAutoFocus to land focus on the Uninstall
    button so Enter confirms immediately.
2026-05-16 feat(webui): replace checkboxes and OTA progress bar with bits-ui
    - Checkbox.Root for Confirm-vehicle-writes, Block-while-moving, and
    Reboot-automatically checkboxes — consistent custom styling with
    data-state-driven checked indicator
    - Progress.Root for OTA flash progress bar — adds role=progressbar
    and aria-value* semantics
    - Move .cbx and .ota-progress-* CSS from scoped component style to
    app.css (required: bits-ui forwards class to its own rendered
    element, which lives outside Svelte's scope chain)
2026-05-16 feat(ble): pairing lock — reject unbonded connections, BOOT button to open
    Non-bonded devices are held for 2.5 s (GATT writes silently dropped,
    sm_bonding=0 so they cannot bond), then receive a {"type":"rejected",
    "reason":"not_paired"} frame and are terminated. Bonded devices connect
    normally. The pairing window opens automatically when the bond store is
    empty (first boot) or when the BOOT button (GPIO9) is pressed; it
    auto-locks after 60 s. Blue LED is solid while the window is open,
    blinks on CAN activity otherwise.
2026-05-16 fix(can): suppress duplicate gpio_install_isr_service error log
    Guard the call with a static flag so the second bus install
    doesn't trigger ESP-IDF's internal error log.
    [can_driver.c]
2026-05-17 build: remove release log-stripping overlay to unify sdkconfig between envs
    Dropping sdkconfig.defaults.release eliminates the sdkconfig.h divergence
    between esp32-c6 and esp32-c6-debug, which was the main driver of full IDF
    component rebuilds when switching environments.
2026-05-17 feat(ble): session-level authorization + Android pairing trigger
    Replace the per-write peer_is_bonded() check with a session-level
    s_conn_authorized flag set at connect time (s_pairing_open || bonded)
    and cleared on disconnect. This lets the pairing window close early
    without invalidating the in-flight connection, so the LED can turn off
    immediately on successful pairing instead of waiting out the 60 s timer.
    During the pairing window, ble_gap_security_initiate() is sent on every
    authorized connect — Android needs the Security Request to know to
    prompt the user; without it, Android never offers pairing. BlueZ/Chrome
    ignore it gracefully and stay connected via s_conn_authorized.
    ENC_CHANG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
2026-05-17 feat(ble): advertising watchdog with reboot fallback
    Periodic 10 s check: when no client is connected and ble_gap_adv_active()
    reports false (failed start, controller stall, race condition), restart
    advertising. If the device fails to recover for 6 consecutive ticks
    (60 s), call esp_restart() to fully reset.
    Critical for an in-car deployment where the BOOT button isn't
    physically accessible — without this, any stuck-BLE state would brick
    the device until power cycle.
2026-05-17 fix(protocol): bail out of send_frame mid-chunk on disconnect
    A disconnect during a multi-chunk frame previously kept calling
    dorky_ble_notify for every remaining chunk. Each failing notify
    allocates an mbuf inside nimble_host's task; under back-pressure
    they accumulate and overflow its stack.
    Check dorky_ble_connected() before each chunk and abort the loop on
    the first notify error. Benefits every push path (responses, traces,
    signals, logs), not just the upcoming log mirror.
2026-05-17 feat(log): mirror ESP_LOG output to the webui log panel
    ESP_LOG calls in C only reached the serial monitor; the webui Log
    panel saw nothing except Berry print(). Hook esp_log_set_vprintf so
    every IDF log line is also pushed over BLE as {type:"log",raw:"..."},
    ANSI-stripped, and the webui parses level/tag/msg with a one-line
    regex. Keeps parsing out of the firmware.
    Berry print() stays on a separate path: plain printf for serial (no
    IDF prefix, bypasses the hook so no duplication) and a structured
    {level:"info",src:"berry",msg} push for the webui.
    Drop ESP_LOGW from dorky_ble_notify — a failed notify inside
    log_push_raw would re-enter the hook and recurse. Builds on the
    preceding send_fra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
2026-05-17 feat(ble): remote unlock-pairing + wipe-bonds from the WebUI
    Adds two device-side ops so a connected client (typically a phone in
    the car) can manage pairing without physical access to the BOOT button:
    - ble.unlock_pairing — opens the 60 s pairing window (same effect as
    a BOOT press) so a second device can be paired.
    - ble.reset_pairs — wipes the NVS bond store, disconnects the
    active client, and re-opens the pairing window.
    WebUI gets a new "Bluetooth" frame in Settings (status + Open-pairing
    button) and a Danger-zone "Wipe bonds" action gated by an AlertDialog
    that warns the user they must also remove "Dorky" from their OS
    Bluetooth settings — the OS will otherwise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
2026-05-17 fix(webui): hide bitrate Apply button when no pending change
    Button now only appears when pending differs from applied, eliminating
    the confusing focus-ring-after-click that made it look stuck active.
    Shows a brief ✓ after successful apply.
2026-05-17 feat(ble): per-device advertised name + show it in the status strip
    BLE advertising name becomes "Dorky-XXXX" where XXXX is the low two
    bytes of the public MAC in hex, so multiple boards on the same bench
    (and in users' OS Bluetooth lists) are distinguishable. The name is
    set in on_sync() because the inferred address isn't readable until the
    host has synced.
    WebUI status strip now renders the real connected device name instead
    of the hardcoded "DorkyCmdr-7F2A" placeholder.
    Also drops the leftover ble_store_clear() TEMP block in on_sync that
    the previous commit message claimed to remove but didn't.
2026-05-17 fix(ble): persist BLE bonds via NimBLE config store
    CONFIG_BT_NIMBLE_NVS_PERSIST was set in sdkconfig.defaults two weeks
    ago but bonds still weren't surviving reboots. Root cause: the NimBLE
    config store callbacks (ble_hs_cfg.store_read/write/delete) were never
    registered, so NimBLE had no store at all — SMP-derived LTKs lived in
    RAM for the session and evaporated on reset.
    Every NimBLE example (and the Arduino BLE wrapper) calls
    ble_store_config_init() once during init; we just missed it. With the
    call in place, ble_hs_cfg.store_* point at the config-based store,
    which (because NVS_PERSIST is set) transparently writes/reads bonds
    to/from the nvs partition.
    Diagnosed with the in-session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
2026-05-17 feat(ble): log SMP pairing events for diagnosis
    Adds case handlers for the three SMP-related GAP events:
    - PASSKEY_ACTION — fired when the central asks for/displays a passkey
    (we use Just Works, so this would only fire if io_cap is changed).
    - PARING_COMPLETE — fires once the SMP exchange finishes, status=0 on
    success. The single most useful diagnostic line; tells us in one
    log whether pairing succeeded and, if not, why.
    - REPEAT_PAIRING — fires when the central re-bonds against a peer we
    already have stored; we return RETRY to accept the new keys (BLE
    spec allows replacement).
    Also bumps the default-case log to DEBUG level so otherwise-silent
    GAP events b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
2026-05-17 feat(ble): hold pairing window open indefinitely while no bonds exist
    Both on_sync (zero bonds at boot) and dorky_ble_reset_pairings (just
    wiped everything) used to call dorky_ble_unlock_pairing(), which arms
    the 60 s lock callout. If nobody connects in that window, the device
    becomes unreachable — the only way back is a BOOT-button press, which
    is impractical for a device hidden in a car.
    Splits the open path into open_pairing_window(with_timeout):
    - with_timeout=true → 60 s window, as before. Used by the public
    dorky_ble_unlock_pairing() (BOOT button / UI).
    - with_timeout=false → window stays open until a successful bond
    closes it via the ENC_CHANGE handler. Used by th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
2026-05-17 fix(ble): stop relying on watchdog to recover from adv start failures
    After a connect or disconnect the controller can refuse adv_start with
    ENOMEM/EBUSY while HCI finishes processing the surrounding events. The
    previous code logged the failure and left the device dark until the
    10 s watchdog tick — usable in the abstract, but a noticeable hiccup
    each cycle and a real outage if anything kept the controller busy.
    Four small changes to make adv recovery synchronous:
    - start_advertising() early-returns when a connection is already
    active. Single-client firmware (s_conn_handle is a single var) so
    advertising during a session would only attract a stranger we'd
    immediately kick.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
2026-05-17 fix(ble): re-open pairing window after a failed connect with zero bonds
    The CONNECT handler optimistically closes the pairing window the moment
    an authorized device connects, on the assumption it will bond. When the
    bond fails — most commonly a 517 (HCI auth fail) caused by the OS still
    having a stale LTK from an earlier device-side wipe — the window stayed
    shut, and the only path back was a BOOT press or a UI unlock op.
    Now DISCONNECT checks: if the link came down with no bond produced and
    the store is still empty, re-open the indefinite window so the user can
    retry after clearing the offending OS bond. Matches the on_sync rule:
    zero bonds == always pairable.
    Successful bond cases are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
2026-05-17 build(pio): auto-regenerate sdkconfig.<env> when defaults change
    PIO's espressif32 platform treats sdkconfig.<env> as user config —
    seeded from sdkconfig.defaults only when missing, then preserved so
    menuconfig edits survive. The downside: edits to sdkconfig.defaults
    are invisible until you manually delete the cached file, and the
    VSCode trash button (pio run -t clean) doesn't touch it either.
    New pre-build script does two things:
    1. Compare mtimes of sdkconfig.defaults* against sdkconfig.<env>
    on every build; if any default is newer, delete the cached file
    and the build's config/ dir so the next build regenerates.
    2. When invoked with -t clean (trash button), also nuke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
2026-05-17 fix(can): clear rx_error after 2 s of no new error counter growth
    TWAI error counters only decrement on successful RX/TX, so they latch
    forever once the bus goes quiet after a bitrate-mismatch episode.
    Track when rx+tx counter sum last grew and ignore the fallback once
    growth has been stale for 2 s, so the status returns to idle naturally.
    [can_driver.c]
2026-05-17 fix(ble): keep advertising during a connection so a 2nd device can discover
    Commit a0886bb made start_advertising() early-return when a connection
    was active. The intent was to avoid the ENOMEM retry spam, but it also
    killed discovery while connected — a hard regression for the original
    "swap PC for phone" flow that motivated the kick-on-new-connection
    logic. With no advertising, no new device can show up to be kicked.
    Restored:
    - start_advertising() no longer early-returns on active connection.
    Attempts adv; if the controller refuses with ENOMEM (concurrent
    adv+conn unsupported in this state) we get one ERROR line per cycle
    instead of an outage.
    - CONNECT handler re-sched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
2026-05-17 build(ble): force SC-only pairing — drop Legacy SMP
    NimBLE has shipped both Legacy and Secure Connections (SC) enabled by
    default. We only ever want SC: the security manager already prefers it
    (sm_sc=1, sm_io_cap=NO_INPUT_OUTPUT), Legacy is just a downgrade path
    and a few KB of dead SMP code.
    Disabling CONFIG_BT_NIMBLE_SM_LEGACY in sdkconfig.defaults locks the
    device to SC. Every BLE 4.2+ central (≈2014 and newer phones/PCs) does
    SC. If a very old central can't pair, this flag is what to re-enable.
    Also adds a "Bluetooth pairing" pointer in the top-level README to the
    new docs/ble.md (coming in the next commit).
2026-05-17 feat(webui): toast notifications for bad BLE connections
    Adds a lightweight, in-house toast component (no new dep) and wires it
    to the BLE transport so the user gets actionable feedback when a
    connection goes wrong instead of a silent state change in the corner.
    Disconnect classification (Web Bluetooth doesn't expose the HCI reason,
    so we infer from timing + intent):
    - 'user' — disconnect() called explicitly. No toast.
    - 'auth_fail' — link came down within 1.5 s of connect, almost
    always the stale-OS-bond 517 path. Toast suggests
    removing Dorky from OS Bluetooth, with a link to
    docs/ble.md for the full explanation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
2026-05-18 feat(log): runtime log-level dropdown in webui Log panel
    Adds a log.set_level op (esp_log_level_set under the hood) and a
    none/error/warn/info/debug/verbose dropdown next to the Clear button
    in the Log panel. Selection is persisted to localStorage and re-sent
    on every (re)connect, so the UI's choice survives a firmware reboot.
    Caveat (documented inline): levels above firmware's compile-time
    CONFIG_LOG_MAXIMUM_LEVEL have nothing to emit — those format strings
    were stripped at build time. So "debug" only does what you'd expect
    on a debug-build firmware. The dropdown still accepts it for tag
    filtering once we expose a per-tag UI.
2026-05-18 fix(can): don't mask TX errors as BUS_GOOD when TX queueing succeeds
    twai_transmit_v2 returns ESP_OK when a frame is queued, not when it's
    ACKed. A failing loopback (no other node, no termination) keeps queuing
    frames fine — so s_last_tx_ms stays fresh and BUS_GOOD was returned
    before reaching the edge/error counter checks, hiding the real failure.
    Now only trust s_last_tx_ms when the TWAI error counters haven't grown
    in the last 2 s. Otherwise fall through to the edge/error fallback so
    the bus correctly reports tx_error.
    [can_driver.c]
2026-05-18 docs: move SCRIPTING.md to docs/scripting.md
    Pure relocation — content unchanged. Joins docs/ble.md so cross-cutting
    documentation lives in one place. Lowercased to match the new convention.
    Updated callers:
    - README.md link
    - firmware/README.md link
    - webui/src/components/views/AIView.svelte (?raw import — the AI
    assistant's scripting context).
    firmware/ARCHITECTURE.md and firmware/ROADMAP.md stay in firmware/
    because they're firmware-internal.
2026-05-18 fix(webui): show info toast when user cancels the BLE picker
    Previously suppressed silent on cancel because "cancel isn't an error" —
    but in practice that left users unsure if the toast UI was even wired
    up. Cancelling the picker is the obvious way to test the feature.
    Now: still distinguish cancel from real failure (info vs error severity,
    shorter duration on cancel) but never go silent on a connect attempt.
2026-05-18 feat(webui): improve PWA install UX for mobile and PC
    - Show install section on iOS where beforeinstallprompt never fires;
    display Share → Add to Home Screen instructions instead of a button
    - Clicking the Dorky logo on PC triggers the install prompt when available
    - Add isIOS detection to platform.ts
2026-05-18 feat(tesla): phase 1 — P-256 keypair management
    Foundation for Tesla BLE control: generate and persist the NIST P-256
    keypair that the car's VCSEC service will check signatures against. The
    actual BLE handshake / signed command flow is NOT included here; see
    docs/tesla-ble.md for the staged plan and the planned integration of
    yoziru/tesla-ble in phase 2.
    What's wired:
    - firmware/src/tesla_ble/{tesla_ble.h,.c} — mbedTLS-backed keygen,
    SEC1 uncompressed pubkey, hex-encoded private key in NVS namespace
    "tesla".
    - Protocol ops: tesla.status, tesla.gen_key, tesla.reset. proto_version
    bumped 4 → 5 in lockstep.
    - WebUI TeslaView replaced (was a disabled wireframe): real st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
    [main.c]
2026-05-18 fix(log): prevent stack overflow when setting log level to info
    esp_log_level_set("*", ...) in ESP-IDF v5 clears all per-tag
    overrides, including the ESP_LOG_WARN suppression on "NimBLE" set
    during BLE init. Raising the level to INFO then allowed NimBLE to log
    "GATT procedure initiated: notify" from within its own notify path —
    the one we call from send_frame → dorky_ble_notify. The vprintf hook
    re-entered, called send_frame again, NimBLE logged again, 17 frames
    deep → stack overflow.
    Two fixes:
    1. Add back the s_hook_active recursion guard in log_vprintf_hook.
    Prevents any re-entrant call (NimBLE or other IDF components
    that log inside their send/notification paths) from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
2026-05-18 fix(webui): explain what to do in connect-fail / cancel toasts
    Toast on a cancelled or failed BLE connect now tells the user the next
    action, instead of just stating that something went wrong.
    - Cancelled picker: "Connect cancelled. Click Connect again and pick
    a 'Dorky-XXXX' device from the browser's Bluetooth picker." (info,
    7 s).
    - Real failure: shows the error plus the most common recovery steps
    (powered? in range? stale OS bond?) and a "More info ↗" link to
    docs/ble.md. Bumped to 12 s so the user has time to read.
    Cancel detection now also matches DOMException name='NotFoundError'
    which Chrome uses, in addition to the existing message-regex match.
    Co-Authored-By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
2026-05-18 feat(tesla): add yoziru/tesla-ble + nanopb as submodules, register as IDF component
    Phase 2 prerequisite: the actual library that implements Tesla's VCSEC
    protocol (ECDH session keys, signed protobuf commands, etc.) is now
    linked into the build.
    Layout (matches the Berry pattern):
    firmware/components/tesla-ble/
    CMakeLists.txt ← our wrapper, registers all sources as an IDF component
    tesla-ble/ ← submodule of yoziru/tesla-ble pinned to v5.0.3
    nanopb/ ← submodule of nanopb/nanopb pinned to 0.4.9.1
    The wrapper registers sources directly instead of invoking the library's
    own CMakeLists.txt for two reasons:
    1. Their build uses FetchContent_Populate to grab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
2026-05-18 feat(tesla): wire phase 1 keypair through yoziru/tesla-ble Client
    Replaces firmware/src/tesla_ble/tesla_ble.c with a C++ glue file that
    delegates to the yoziru/tesla-ble library now linked in by the previous
    commit. The C API (tesla_ble.h) is unchanged so protocol.c / main.c
    callers don't need touching.
    Key differences from the hand-rolled C version:
    - Source of truth for the key is TeslaBLE::Client. NVS now stores a
    PEM-encoded EC private key (~227 bytes) instead of a hex-encoded raw
    scalar, because Client::load_private_key feeds the bytes through
    mbedtls_pk_parse_key which expects PEM or DER. Any keypair generated
    on the old firmware is incompatible and must be regenera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
2026-05-18 feat(settings): wire up Factory reset
    system.factory_reset op formats LittleFS (scripts + .enabled list) and
    erases the NVS partition (bonds, WiFi creds, secrets, Tesla key), then
    reboots. proto_version bumped to 6.
    Webui shows a confirm dialog that warns about the bond wipe and the
    need to remove "Dorky" from OS Bluetooth before reconnecting.
2026-05-18 kicad 10
    [ESP32-DualCAN.kicad_pcb, ESP32-DualCAN.kicad_sch]
2026-05-18 update pcb
    [ESP32-DualCAN.kicad_pcb, ESP32-DualCAN.kicad_sch]
2026-05-18 feat(tesla): BLE central scan for Tesla VCSEC service UUID
    New C module tesla_central.{h,c}:
    - Filters scan results on the Tesla 128-bit VCSEC service UUID
    (00000211-b2d1-43f0-9b88-960cebf8b91e)
    - Accumulates up to 8 unique devices with name, MAC, RSSI
    - Fires a done-callback from the NimBLE host task when the window ends
    - Coexists with the existing peripheral role (MAX_CONNECTIONS=2 already set)
    New protocol op tesla.scan {duration_ms?} -> {devices: [{addr,name,rssi}]}:
    - duration_ms defaults to 5000, clamped to [500, 30000]
    - Response arrives asynchronously when the scan window closes
    Central role is already enabled by default (CONFIG_BT_NIMBLE_ROLE_CENTRAL=y)
    so no sdkconfig changes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
2026-05-18 feat(tesla): BLE central connect + GATT discover + write
    Extends tesla_central.{h,c} with the connect-to-car flow:
    State machine: IDLE → CONNECTING → DISC_SVC → DISC_RX_CHR → DISC_TX_CHR
    → DISC_CCCD → SUBSCRIBING → READY
    - ble_gap_connect() with 30 s timeout
    - Discovers Tesla VCSEC service (UUID 00000211-…) by UUID
    - Discovers RX characteristic (00000212-…) — write target
    - Discovers TX characteristic (00000213-…) — indication source
    - Discovers CCCD descriptor and writes 0x0002 to subscribe to indications
    - Incoming indications routed through tesla_central_rx_cb_t callback
    New public API:
    tesla_central_connect(addr, addr_type, on_connected, on_dis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
2026-05-18 feat(main): factory reset on 15 s BOOT button hold
    Short press (<15 s) still unlocks the pairing window. Holding for 15 s
    wipes LittleFS + NVS and reboots into first-run state.
    LED counts down: blinks every 300 ms after 3 s held, accelerates to
    100 ms after 10 s, then goes solid at trigger.
    [main.c]
2026-05-18 feat(tesla): wire TeslaBLE::Vehicle with NVS + NimBLE adapters + tesla.pair op
    New module tesla_vehicle.{h,cpp}:
    NvsStorageAdapter:
    - "private_key" → NVS "tesla"/"pem" (PEM bytes fed directly to Vehicle's Client)
    - "session_vcsec" → "s_vcsec" (hex-encoded binary session state)
    - "session_infotainment" → "s_info"
    NimbleBleAdapter:
    - write() → tesla_central_write() (no-rsp to car's RX characteristic)
    - connect()/disconnect() driven externally by us, not by Vehicle
    Vehicle lifecycle:
    - Constructed at boot via tesla_vehicle_init() (lazy key load via StorageAdapter)
    - VIN set from NVS immediately after construction
    - FreeRTOS task calls Vehicle::loop() every 100 ms for command queue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
2026-05-18 docs: document BOOT button actions in README and docs/button.md
    Short press: open pairing window. Hold 15 s: factory reset.
    LED countdown behaviour documented. ble.md cross-references button.md.
2026-05-18 feat(webui): Tesla scan/pair/VIN UI in TeslaView
    Replaces the placeholder "not yet wired" section with a working UI:
    - VIN field: enter, validate (17 chars), save via tesla.set_vin
    - Keypair section: generate/regenerate/wipe (existing, unchanged)
    - Pair section: Scan (6 s) → device list → Pair button per device
    - Shows ad name + MAC + RSSI from tesla.scan result
    - Pair fires tesla.pair, waits for whitelist-msg ack
    - Toast guides user to tap keycard/phone in car to approve
    New protocol methods: teslaSetVin, teslaScan, teslaPair.
    Updated teslaStatus/teslaGenKey return type to include vin?.
2026-05-18 feat(webui): gate Tesla-BLE nav on Tesla car selection, disable other brands
    - Rail: Tesla-BLE nav item only shown when app.car.brand === 'Tesla'
    - CarPicker: non-Tesla rows are disabled (opacity + cursor) with
    'coming soon' badge on non-Tesla brand headers
    - store: pickCar/clearCar redirect away from tesla view when car isn't Tesla
2026-05-18 fix(webui): allow scanning without a keypair; only gate Pair button on key
    Scan just listens for BLE advertisements — no key needed. Moving the
    key guard from the whole section down to the Pair button per device,
    with a tooltip explaining why it's disabled when no key exists.
2026-05-18 refactor(webui): move Scan/Pair to top of TeslaView
    Order is now: Pair with vehicle → Vehicle (VIN) → Keypair.
    Scan is the first action a user takes; key setup is secondary.
    Updated "Generate a keypair above" hint to "below".
2026-05-18 fix: flipped VehicleCAN pins
    [ESP32-DualCAN.kicad_pcb, ESP32-DualCAN.kicad_sch]
2026-05-18 docs: add maintenance guide — USB cable recovery without BOOT button
    Covers erase_region recipes for each partition (NVS, LittleFS, both)
    with exact addresses from partitions.csv, plus full erase+reflash.
    Useful when the device is hidden under a trim panel and the BOOT button
    is inaccessible.
2026-05-18 docs(ble): rewrite ble.md scenario-first; absorb button.md; link maintenance.md
    ble.md now leads with "Can't connect?" fix steps before any technical
    detail. Sections:
    1. Can't connect? — 4-bullet quick checklist
    2. Troubleshooting scenarios — each with numbered steps, plain language
    3. BOOT button — absorbed from button.md (short press / factory reset /
    LED countdown table)
    4. Device is hidden — pointer to maintenance.md for USB cable recovery
    5. Technical reference — identity, security model, advertising,
    developer troubleshooting matrix, code pointers (moved to bottom)
    button.md deleted (content fully absorbed into ble.md).
    README updated to point to ble.md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
2026-05-18 docs(ble): inline USB cable recovery commands; delete maintenance.md
    maintenance.md deleted.
2026-05-18 can silk on top
    [ESP32-DualCAN.kicad_pcb]
2026-05-18 feat(webui): phone-side Tesla BLE scanner when Dorky not connected
    When the device is disconnected, TeslaView now shows a "Nearby Teslas"
    frame instead of a dead empty state. Uses Web Bluetooth requestDevice
    filtered on the Tesla VCSEC service UUID (00000211-…) — the browser's
    picker shows only matching Tesla advertisements.
    After the user picks a car:
    - Shows the advertisement name (S<SHA1(VIN)[0..8]>C)
    - Attempts to connect and read the version characteristic (00000214)
    for a "reachable" confirmation; silently skips if auth is required
    Falls back gracefully on iOS / Firefox where Web Bluetooth is absent.
    Includes a one-liner explaining the name hash format.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
2026-05-18 fix(webui): resolve all svelte-check a11y warnings; bump svelte + devalue
    - Rail: use {#if} + snippet to render proper <button> when canInstall, avoiding static-analysis false-positive on conditional tabindex
    - CarPicker/DashboardView: add onkeydown + tabindex=-1 to dialog divs
    - Toast: role="status" → role="button" (element is interactive; aria-live is on parent)
    - svelte 5.55.5 → 5.55.7, devalue 5.8.0 → 5.8.1 (audit fix)
2026-05-18 ci(hardware): add hw-v* release workflow — schematic PDF + iBOM dark
    Exports schematic via kicad-cli and interactive BOM (dark mode) via
    interactivehtmlbom CLI on every hw-v* tag. Gerbers excluded — use the
    KiCad fabrication toolkit plugin locally for those.
2026-05-18 feat(webui): tap bus pip to debug — Trace on error, Settings on idle
    Clicking a bus status pip now routes based on what the status implies:
    - rx_error / tx_error / error → Trace view, pre-filtered to that bus
    - idle → Settings (bus bitrate config)
    - good → Trace view for that bus
    Adds tracePendingBus cross-view handoff consumed by TraceView on mount.
2026-05-19 build: auto-sync git submodules on pio build
    Adds a pre-build script that runs `git submodule update --init --recursive`
    before every build, so a `git pull` that bumps a submodule pin is reflected
    in the tree without manual intervention. Also runnable standalone:
    `python firmware/tools/sync_submodules.py`. README documents the initial
    clone step.
2026-05-20 fix(scripts): correct DI_accelPedalPos message name; add can_signal_get demo
    track_mode_on_full_throttle: DI_accelPedalPos lives in DI_systemStatus
    (ID 280), not DI_torque (ID 264). The wrong message name silently
    dropped every on_can_signal callback, so the script never fired.
    Add tesla_gear_led_demo.be — a new example that polls DI_systemStatus
    every 250 ms via can_signal_get (rather than the event-driven
    on_can_signal pattern), maps DI_gear to LED colour (P=white, R=red,
    N=yellow, D=green), and registers a "hazards" tile that sends
    DAS_bodyControls (ID 1001) with proper checksum/counter finalization.
    https://claude.ai/code/session_0177WKw62JV7FSuQHRCKiAoM
2026-05-20 feat(dbc): add DI_speed, UI_vehicleControl, UI_powertrainControl to embedded DBC
    The embedded vehicle DBC previously had only 11 messages. The mirror-fold
    and track-mode scripts referenced messages that were absent, so
    can_msg_get always returned nil and no TX frame was ever sent.
    Add three message definitions to tesla_model3_vehicle.dbc:
    DI_speed (599) — DI_vehicleSpeed for speed reading
    UI_vehicleControl (627) — UI_mirrorFoldRequest, UI_honkHorn, etc.
    UI_powertrainControl (787) — UI_trackModeRequest with checksum/counter
    Regenerate vehicle_dbc_embedded.h (14 msgs, 223 sigs, 9176 bytes).
    Also add --header flag to dbc2bin.py so the embedded header can be
    regene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
2026-05-21 feat(bus): report real RX frame rate in the bus pip
    The bus pips were showing hardcoded "488 f/s" / "122 f/s" placeholders
    regardless of actual bus traffic. Track per-bus RX count in can_poll,
    roll a 1 s window for a frames/sec snapshot, and ship it alongside the
    bus_status push (with a 1 s heartbeat so the rate ticks even when the
    state is steady).
2026-05-21 fix(bus): stop pip flapping on a flaky loopback
    The bus health heuristic was timestamping every growth in TEC+REC and
    locking the bus into a non-GOOD state for 2 s after each bump, even
    when frames were still flowing. A loopback rig with weak ACK behaviour
    (or a stale boot-time TEC that never decrements because the bus never
    transmits) made the pip oscillate between good and rx/tx_error every
    second.
    Replace the growth-based gate with the CAN spec's live error-passive
    threshold: only call the bus failing once TEC or REC hits 128. Below
    that the controller's retry machinery still gets frames through, and
    the pip stays GOOD as long as TX/RX is happening within the 1 s
    window. Hard failures (B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
    [can_driver.c]
2026-05-22 actually instantiate the list class. Now we can read the frame
2026-05-30 scripting: allow can_msg_get(name) — accept DBC message names; update docs/examples
2026-05-30 feat: add smart autoscroll to log pane
    - Auto-scroll to bottom on new log entries
    - Lock at bottom when at the bottom, unlock when scrolling up
    - Add scroll-to-bottom button between Clear and Close buttons
2026-05-30 Add layered error codes for DBC and CAN lookup failures
    DBC layer (dbc_pack.h):
    DBC_ERR_NO_SIG (-101) — signal name not found
    DBC_ERR_NO_MSG (-102) — message name not found
    CAN layer (can.h):
    CAN_DBC_ERR (-201) — DBC lookup failed (wraps both DBC misses)
    CAN_ERR_FULL (-202) — callback registry full
    All int-returning DBC/CAN functions now use named error codes instead
    of raw -1. Berry bindings check the exact error for precise error
    messages without re-doing the DBC lookup.
    [can.c, can.h]
2026-05-30 ScriptsView: restore last-opened script + scroll pos across tab switches
    - Persist last-opened script filename in localStorage (dc-last-script)
    - Remember scroll position per script in AppState Map (survives tab switch)
    - Add scrollTop binding to CodeMirrorEditor for bidirectional sync
    - Use mounted guard to prevent double refresh() race on mount
    - Save scroll position in onDestroy so tab switch captures it
2026-05-30 ble: guard against duplicate gattserverdisconnected on Windows
    Windows Web Bluetooth can fire the disconnect event twice for a single
    disconnect. The second call sees userInitiatedDisconnect already reset
    to false and misclassifies it as 'unexpected', triggering a misleading
    toast. Track handled disconnects to skip duplicates.
2026-05-30 Keep all views mounted, hide inactive ones via display:none
    Replaces the {#if}/{:else if} destroy/recreate pattern with
    always-mounted div wrappers toggling display:none. Component
    state (selected script, editor content, scroll position) now
    survives tab switches naturally, removing the need for the
    mounted guard, onDestroy scroll save, and store scroll map.
2026-05-30 Fix show/hide layout: wrapper divs need flex:1 when visible
    Active wrapper divs now use 'flex: 1; display: flex; flex-direction:
    column; min-height: 0' so views fill the available space instead of
    collapsing vertically. Also removed the ResizeObserver hack from
    CodeMirrorEditor — it caused layout jumps and the scrollbar issue
    was actually due to the missing flex sizing.
    DashboardView: refresh action list when tab becomes visible
    With show/hide, all views stay mounted. DashboardView only
    refreshed on mount + reconnect, so switching away and back left
    stale data. A on app.view calls refresh() whenever the
    Events tab is selected.
2026-05-30 ScriptsView: remove red uninstall button from editor toolbar
2026-05-30 DashboardView: fix tile error decorator reactivity + auto-clear
    Switch from (Map) to (Record) so property access
    tileErrors[ev.id] is tracked by Svelte 5's proxy. The Map.get()
    call was not reactive, so the error decorator never appeared.
    Also clear tileErrors when switching to Events tab, so stale
    errors don't persist across view switches.
2026-05-31 refactor: extract berry completions/hover/context into berry-completions.ts
    - Move DBC-aware autocomplete, context detection (findContext, findDbcCall),
    Berry API bindings, keyword list, and berryHover into dedicated module
    - Add filterText to DBC completions so quoted labels match unquoted typing
    - Fix scroll sync: ResizeObserver replaces broken (hidden editors)
    - Comments now show DBC name completions
    - Berry API functions only proposed at statement start
2026-05-31 private DBC per car, fix log, remove load Tesla button
2026-06-01 protocol: reset rxBuf and reject pending on disconnect
    Clears stale buffer data and pending promises so reconnection
    starts with a clean state instead of corrupting frame parsing.
2026-06-01 remove DBC runtime dependency; preprocessor generates inline Berry signal code
    - Delete firmware/src/dbc/ entirely (dbc_pack, dbc_types, embedded DBC, decode test)
    - Rewrite can.h/c: frame cache by id mod 32, no DBC types, simplified can_send()
    - Rewrite msg_codec.h/c: pure bit ops only (bit_extract, bit_insert, signal_decode, signal_encode)
    - Simplify tesla.h/c: only tesla_checksum remains
    - Berry bindings: register 4 CAN utility functions, remove signal subscribe/value ops
    - protocol.c: remove signal subscribe/unsubscribe/value handlers
    - script_loader: add script_loader_delete_runtime() to delete stale .bep
    - protocol.c: handle_script_write deletes .bep when no runtime provided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
    [can.c, can.h, main.c, msg_codec.c]
2026-06-01 webui: auto-recover from stalled BLE notification stream
    The Web Bluetooth notification stream (characteristicvaluechanged) can
    silently stop firing on some platforms while the GATT connection appears
    healthy. Writes still reach the firmware but response notifications are
    never delivered, causing every protocol call to time out.
    - Protocol tracks lastRxTimestamp; fires onStall() once when a call()
    timeout detects no data received for >10s while connected.
    - BleTransport.restartNotifications() re-subscribes to TX notifications
    without disconnecting. BleTransport.reconnect() tears down and
    re-establishes the session to the same device (no BLE picker).
    - Store wires onStall to recoverSta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
2026-06-01 add Radio view with Perchance generator iframe
    - new RadioView.svelte with iframe to null.perchance.org/radio-box-2-lite
    - register 'radio' ViewId in store.svelte.ts
    - add radio icon (rectangle + antenna + speaker + grill) to icons.ts
    - add Radio nav item in nav.ts (Fun group)
    - wire up in App.svelte
2026-06-01 add tooltip titles to nav rail item buttons
2026-06-04 add signal & message search to DBC view
    - Search bar with debounced input (120ms) for smooth typing
    - Filters both message names and signal names in real time
    - Auto-expand when <20 results, auto-collapse on clear
    - Matching text highlighted in signal names
    - Per-message match count in header
    - Empty state when no matches
2026-06-07 Fold script buttons on mobile
2026-06-08 fix svelte-check warnings in LogPane.svelte
    Wrap .log-link CSS in :global() for {@html} content. Add role=button + tabindex + onkeydown for a11y click-handler compliance. npm run check now 0 errors, 0 warnings.
2026-06-08 Shrink Scripting guide button
2026-06-08 view rail list not scrollable
2026-06-09 add signal & message search to DBC view
    - Searchable by CAN ID (hex and decimal) with dedicated Dec column
    - Matching text highlighted in green (IDs, signal names)
    - Show all signals when message name/ID matches
    - Fix pre-existing null check in ScriptsView
    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
2026-06-09 compact-first expand with show-other-signals toggle
    - Always show compact view (only matching signals) on expand
    - Collapse resets per-message show-all state
    - Enter expands all visible messages in compact mode
    - Show other signals button to reveal full signal list
2026-06-19 can_msg_new - dont specify bus for draft message. Specify bus for can_msg_get can_msg_send — swapped arg order from (draft, bus) to (bus, draft)
    [can.c, can.h]
2026-06-22 can_recv_raw now requires both bus and msg_id - no Fifo currently, we store and read last value
2026-06-23 Error traceback line number for timers and events
2026-06-26 Remove search rail item. Bring log icon on mobile. Fix ctrl+k label.
2026-06-28 Improve loopback test: verify can_msg_send wire output via CAN RX
    - After each can_msg_send, read back the looped-back frame via
    can_recv_raw(bus, id, 50) and assert the received bytes match
    the draft's data payload.
    - Previously the test only checked msg_sig_set ↔ msg_sig_get
    consistency within a single draft object, silently accepting
    garbage on the wire (id=0, dlc=0 from the .p member bug).
    Fix test: read loopback on bus 1 (physical wiring), not bus 0 (internal)
    TWAI_MODE_NORMAL is used, not internal loopback. CAN0 and CAN1
    transceivers are physically wired together on the bench (TX0→RX1,
    TX1→RX0). Read back on bus 1 to verify wire output.
2026-07-03 autocomplete: scope signal completions by draft variable's message
    - Import buildVarToMsgMap from preprocessor to track which message a
    draft variable refers to (shared logic with preprocessor validation)
    - msg_sig_get/set arg1 now shows only signals from the tracked message
    - can_msg_get arg1 shows messages filtered by parsed bus number
    - findContext now correctly skips line comments (#) instead of treating
    any # as comment context (broke scoping in scripts with header comments)
    - dbcCompletions routes each function explicitly instead of fallthrough
    - Add preprocessed form to API tooltip docs
2026-07-03 feat(editor): arg hints tooltip, fix atStart/comment context
    - Add StateField+showTooltip arg hints showing function signature with highlighted current parameter
    - Remove DBC signal/message names from statement-start completions (only API functions/keywords)
    - Remove keyword completions when cursor is inside function call parens
    - Fix findContext to return 'comment' when # runs to end of text (no \n after)
    - Add warm theme CSS for arg hints tooltip
2026-07-03 Improve autocomplete: remove snippets, fix word replacement, filter keywords
    - Remove snippetCompletion (inserts parens conflicting with existing text)
    - Use plain completion objects that just insert function names
    - Extend word end past cursor to consume trailing letters (pri|nt -> print)
    - Remove validFor to prevent duplication on accept (print -> printnt)
    - Pass wordEnd through dbcCompletions for consistent word replacement
    - Always show API functions, only show keywords at statement start
2026-07-03 track mode on pedal
2026-07-04 CLear editor when switching to avoid stale scripts
2026-07-05 fix: corrupted ble frames - adds mutex to avoid mixing frames, also yield between chunks
2026-07-05 retry dorky_ble_notify on transient backpressure (mutex + 100x retry)
    Wrap send_frame in a mutex so concurrent calls (dispatch + log hook)
    don't interleave chunks on the wire. When notify returns non-zero
    (NimBLE queue full or mbufs exhausted), retry up to 100 times
    with 10 ms delay between attempts instead of breaking the frame.
2026-07-05 fix script large loads etc: start call timeout after dispatchFrame begins, not at call() creation
    When BLE wakes from idle, it can take several seconds before the
    first chunk actually goes on the wire. Previously the timeout timer
    started counting at call() creation, so a 5 s timeout might fire
    before a single byte was sent. Now the timer starts after the frame
    enters the dispatch loop, giving the radio realistic time to wake.
    readScript timeout also bumped from 5 s to 10 s to cover this.
2026-07-05 dynamic notify chunk size from ATT MTU; filter NimBLE logs from BLE hook
    send_frame now queries dorky_ble_mtu() and sizes each chunk to
    min(mtu - 3, 200) — fewer notifies for large responses (~16 vs ~40
    for an 8 KB script.read) means less NimBLE mbuf churn and queue
    pressure, which should reduce the accumulated slowdown over hours.
    Also adds the NimBLE log filter in log_vprintf_hook (strstr for
    ') NimBLE:') so internal stack alloc/notify logs don't re-enter
    send_frame from the host task — the mutex serializes main-task
    calls but can't stop the host task from barging in.
2026-07-05 faster updates: add ble.mtu op so client can size write chunks dynamically
    Client queries the negotiated ATT MTU on connect and sets its BLE
    write chunk to MTU-3 (up from a fixed 180), reducing the number of
    per-chunk write calls during OTA by ~2.8x.
    Firmware-side handler dorky_ble_mtu() returns the current negotiated
    value, or 0 if not connected.
2026-07-05 faster updates: increase OTA stream chunk 4K → 16K
    Fewer round trips per firmware upload = faster OTA, especially in
    noisy RF environments like a car. 16K fits comfortably within the
    device's 32 KB RX buffer plus frame header overhead.
2026-07-05 migrate BLE transport from Web Bluetooth to @capacitor-community/bluetooth-le
    - Replace raw navigator.bluetooth calls with BleClient API for
    cross-platform BLE support (Android, iOS, web)
    - Add reconnect guard (reconnecting flag) to suppress stale
    disconnect events during session teardown
    - Add disconnectHandled guard for duplicate disconnect callback
    - Fix connect() marking UI as connected after auth-fail disconnect
    during notification setup (deviceId guard)
    - Convert TeslaView phone-side scanner to use BleClient
    - Clean plugin state on connection failure to avoid page-refresh
    requirement for retry
2026-07-24 switch from muxed doorStatus2 to doorClosureStatus
2026-08-05 ESP32-C6-Zero alternative comments
    [ESP32-DualCAN.kicad_sch]
2026-08-08 Use 8MB ESP32-C6-Zero
    [ESP32-DualCAN.kicad_pcb, ESP32-DualCAN.kicad_sch]
2026-08-09 cheap connector
    [ESP32-DualCAN.kicad_pcb, ESP32-DualCAN.kicad_sch]
2026-08-10 DNP input filtering. Changed vout resistors
    [ESP32-DualCAN.kicad_pcb, ESP32-DualCAN.kicad_sch]
2026-08-12 cheaper parts, tooling holes
    [ESP32-DualCAN.kicad_pcb, ESP32-DualCAN.kicad_sch]
2026-08-12 Add power selector for can transceivers
    [ESP32-DualCAN.kicad_pcb, ESP32-DualCAN.kicad_sch]
2026-08-12 common 0603 100nF caps
    [ESP32-DualCAN.kicad_pcb, ESP32-DualCAN.kicad_sch]
2026-09-03 Vbat solder bridge for ESP32-C6-Zero-B
    [ESP32-DualCAN.kicad_pcb, ESP32-DualCAN.kicad_sch]
2026-09-03 v2.0 silk - for ESP32-C6-Zero pin mapping
    [ESP32-DualCAN.kicad_pcb, ESP32-DualCAN.kicad_sch]
2026-09-03 kicad 10 CI
2026-09-03 ci(hardware): fix iBOM install for PEP668 and module case
2026-09-03 ci(hardware): run iBOM under xvfb for headless KiCad 10
2026-09-04 docs: reorganize READMEs, split hardware/dbc/scripts guides
    - Root: Flash (Web UI OTA Web Flasher first, USB download) + Connect BLE with consolidated BOOT/pairing Note/Tip + Choose car / Install first script (Gallery) / Use action tiles (Tesla fold mirrors) + AI edit (BYOK localStorage/NVS) + Write your own scripts (Scripting Guide); hardware spec moved to hardware/README.md leaving high-level BLE/WiFi/CAN
    - Firmware: remove Steps 1-5 walkthrough (now in root), keep Berry reference, split Development into Build & Flash / Monitor & Test with PlatformIO extension and pio run -e esp32-c6, clone submodules only in firmware, validate BOOT times (short <15s / hold >=15s) against main.c
    - New hard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
2026-09-21 feat(webui): persist BLE device and auto-reconnect on disconnect
    Remember the last connected BLE device (id + name, dc-ble-device) and attempt a
    picker-less reconnect on every non-user disconnect with a 2.5/4/6/8s backoff.
    Show "Reconnecting..." in the status strip and fall back to a manual Connect
    prompt only after retries are exhausted. OTA/reboot drops take the same path with
    reboot-specific copy; a deliberate Disconnect never auto-reconnects.
    auto-reconnect if dorky connection lost - e.g. on reboot
2026-09-21 test(webui): add BLE reconnect test tiers and testability seams
    Add mocked (node --test) and opt-in real-hardware (Playwright) coverage for the
    existing BLE auto-reconnect behavior:
    - mocked tier: reconnect classification, backoff exhaustion, reboot routing,
    concurrent-drop guard, stalled-stream recovery, mid-sleep recovery, and
    connect-toggle lockout
    - real-device tier (headful "ble-real" project): chooser connect -> drop ->
    silent reconnect, plus a simulated reboot delay; self-skips without a dorky
    device and when CI/BLE_SKIP_REAL_DEVICE is set
    Add test seams: BleClientPort for BleTransport injection and injectable AppState
    deps; reconnect backoff is now [1500, 2500, 4000, 6000,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
2026-09-25 silk, pcba
    [ESP32-DualCAN.kicad_pcb, ESP32-DualCAN.kicad_sch]
2026-10-04 webui: remove browser-based Tesla scanner
    Android Chrome filters Tesla advertisements (iBeacon-format payloads) from Web Bluetooth scans, so the browser scanner cannot work. The Tesla view now shows a connect-to-Dorky note while disconnected; scanning lives on the ESP32 via tesla.scan.
2026-10-05 firmware: Tesla BLE scan - match name or VCSEC UUID, active scan
    Legacy 'S<16-hex><C|R|D|P>' and current 'Tesla <last6>' advertisement names now match, in addition to the 0211 service UUID when present. Active scan so names delivered in the scan response are seen. Per-advertisement diagnostics at debug level; INFO keeps scan start/done and match lines. NimBLE max connections 3 so the WebUI peripheral and Tesla central coexist.
2026-10-08 firmware: selectable Tesla key role, addr_type in scan, pair fails fast
    tesla.pair takes an optional role (driver default; owner must be chosen explicitly) instead of hardcoding ROLE_OWNER. tesla.scan results include addr_type so connects use the car's actual address type. A disconnect before the whitelist round-trip completes now fails the pair call with a decoded HCI reason instead of hanging until the client timeout. Adds tesla_central_reason_str() (e.g. 574 -> HCI 0x3E connection failed to be established).
2026-10-08 webui: Tesla role picker, pass addr_type on pair
    Key role select (Driver default) next to Scan; pair sends the scanned addr_type and chosen role.
2026-10-12 MLMR16006Y needs pull up on enable pin
2026-10-12 fix(webui): manual Disconnect cancels auto-reconnect; add picker escape hatch
    Tapping Disconnect while Reconnecting was ignored (toggleConnect and the status-strip handler both early-returned on reconnecting), so the loop kept retrying the same board. toggleConnect now cancels the loop via a generation-guarded cancelReconnect, and the loop observes cancellation before every attempt.
2026-11-03 fix(scripting): keep timer/action ownership through callbacks
    Timers and actions registered from inside a timer callback or an action
    body were tagged script_id 0: berry_timer_tick()/berry_action_invoke()
    re-entered Berry without installing the entry's owner. Script 0 is never
    cleaned up, so those entries outlived disable and delete: they kept firing
    (CAN writes after the user disabled the script) and could fill the 16/16
    and 32/32 registries until reboot, after which timer_every() returns nil
    for every script.
    - tick/invoke install the owner around be_pcall and restore the previous
    context. The owner is snapshotted before the call because a one-shot
    callback may reuse its own slot.
    - d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
2026-11-03 fix(scripting): balance the Berry value stack on failed calls
    be_pcall leaves two slots above the watermark on success ([list, result])
    but four on error ([list, closure, type, message]), so the fixed pop(2)
    in berry_call_ref/berry_timer_tick/berry_action_invoke kept [list, closure]
    on the VM stack after every failure: the stack grew two slots per failed
    call and the closure stayed reachable. be_setglobal also leaves its value
    behind, so refs_alloc leaked one slot when it created ".refs" and
    berry_capture_global leaked one per captured global (two per enable).
    Capture be_top() before the call and restore to that watermark with
    berry_stack_restore() instead of guessing the pop count. Reprodu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
2026-11-03 fix(scripting): tighten owner diagnostics; keep probe out of the gallery
    - SCRIPT_ID_NONE names the no-owner sentinel. The warning moved into
    alloc_timer/action_register, where a slot actually exists, so it no longer
    fires before a possible "registry full" and reports a registration that
    never happened.
    - enable() saves and restores the caller's context like disable().
    - berry_call_ref documents that it does not install a context.
    - The timer ownership probe moves to test_scripts/manual/ so it is not
    bundled into the UI example picker or the generated preprocessing test.
    parse_check_examples.sh still covers it.
2026-11-03 fix(webui): link app.css from index.html, register the SW in prod only
    Style tokens and utilities were loaded through the JS module graph, so
    the app's styling depended on the entry module resolving. Linking
    app.css from index.html takes it out of that graph: Vite serves it as
    text/css in dev and bundles it into the same CSS asset as before, so
    the shipped CSS is byte-identical.
    The service worker now registers in production only and fetches
    network-first, with the cache as an offline fallback, and the cache name
    is bumped to dorky-v2. The device serves the UI over plain HTTP, which
    is not a secure context, so no worker registers there; this affects
    GitHub Pages, where installability is pre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
2026-11-03 fix(scripts): clear latched requests from teardown
    Disabling a script now cancels its pending one-shots, so a clear frame armed
    with timer_after() is skipped when the user disables inside the window. Send
    it synchronously from teardown(), which runs before the sweep:
    - light_flash_horn_beep: extract horn_off() and call it from teardown.
    - tesla_blink_hazards_tile: call hazards_off() from teardown.
2026-11-03 tools: check out shell scripts with LF
    Windows checkouts turned tools/*.sh into CRLF because of '* text=auto', so bash stopped on the shebang line before running anything. Pin *.sh to LF.
2026-11-03 fix(webui): load the scripting guide from the deploy base
    The guide fetched '/docs/scripting.md', an origin-root path. GitHub Pages
    serves this app under /<repo>/, so the request missed and the modal showed
    a 404. The path now goes through BASE_URL, which is what the DBC entries in
    sampleData.ts already do.
    A test fails when any file under webui/src fetches from the origin root, so
    the next one of these is caught before it reaches a phone.
2026-11-03 refactor(webui): use one balanced scanner for calls and args
    Replace findMatchingParen and splitTopLevelArgs with a single scanArgs pass that returns the matching close paren and top-level argument slices, so bracket policy and string/comment handling cannot drift.
2026-11-03 refactor(scripting): split the script registry from the hardware bindings
    berry_bindings.c was 1000 lines mixing CAN/LED/NVS bindings with the
    script-owned registration lifecycle. Move the latter into berry_registry.c:
    script context, function refs, timers, actions, cleanup, and the VM error
    formatter. berry_bindings.h re-exports the registry header, so existing
    callers keep one include; berry_register_bindings() calls
    berry_register_registry().
    No behavior change: sections moved verbatim, same registration order, same
    tag and statics. berry_bindings.c is 466 lines and the registry 525; both
    are back under the 1k line.
2026-11-03 test(scripting): run the Berry timer ownership cases on the host
    Add a host env that compiles the vendored Berry VM and berry_registry.c
    against stubbed ESP-IDF logging and a settable clock, so timer ownership
    and the value-stack watermark are covered by `make test-fw` and CI
    instead of only on device.
    - test_berry_timers: a timer armed inside a timer callback is revoked by
    berry_cleanup_script(owner), a timer armed inside an action is revoked,
    and five failed calls leave the value stack at its watermark.
    - tools/build_berry_native.py: extra script scoped to tests-native-berry;
    BuildSources for components/berry and src/scripting/berry_registry.c,
    with the stub headers first on the i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
2026-11-03 refactor(webui): classify string arguments honestly
    Replace the malformed bucket with code and unterminated. A concatenation such as "UI_" .. "counter" is valid code, not a broken literal; it now reports that a compile-time string is required. Computed message names fail the same way instead of passing through.
2026-11-03 fix(webui): the install logo explains itself instead of doing nothing
    The brand rendered as an install button only when the browser had an
    install prompt, and isMobile is a user-agent check, so on a phone the logo
    looked tappable and had no handler at all.
    Every tap now ends in an outcome. With a prompt it installs. When the app
    is installed it says so. With no prompt it says where the app is, and iOS
    gets the Share route Safari needs.
2026-11-03 test(scripting): share the Berry host harness
    Make the host env ready for the lifecycle, error and action suites:
    - move the log declarations to berry_log.h, so script_loader.c includes the
    registry and log headers instead of the CAN/LED/NVS umbrella
    - move the host stubs to test/berry_common and compile them once for every
    berry suite
    - add test/berry_common/berry_test.h (run, capture, enable, global read) and
    move test_berry_timers onto it
    - compile script_loader.c in the berry env; SCRIPT_DIR_TEST selects a
    writable relative scripts directory for host suites, and _WIN32 aliases
    mkdir (the device path is unchanged)
    No behavior change. make test-fw: 41/41; berry_bindings.c and s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
2026-11-03 feat(webui): parse calls into nodes with source spans
    Build call nodes from the token stream, match brackets, split top-level
    arguments, and render replacements over source spans. Nested calls fall out of
    the argument structure; a no-op rewriter reproduces the input byte for byte, so
    comments, whitespace, and escapes survive.
2026-11-03 test(webui): add differential and fuzz coverage
    Add a differential tool against bc24000 and a seeded fuzz suite. The
    differential covers all real .be files and all 1,121 DBC messages; the fuzz
    checks determinism, span bounds, no quoted names in DBC call positions, and
    idempotence. Current result: 0 diffs, 63,036 signals covered, 200 fuzz cases.
2026-11-03 refactor(webui): tighten preprocessor contracts
    Sort punctuation by length so longest-match does not depend on list order.
    Point argument spans at the delimiter end and give them the matching line and
    column. Carry the opener token in the bracket stack so the unclosed-bracket
    path needs no unreachable guard. Model resolved signals as a discriminated
    union.
2026-11-04 refactor(webui): move Capacitor wiring to a composition root
    The plugin client and Capacitor were imported only for values the mock
    tier never uses: a default BleTransport argument and a web/native check.
    `npm test` therefore needed node_modules for imports that a plain Node
    run cannot resolve.
    BleTransport now takes the client and an isWeb predicate from its
    caller, and ble.ts keeps type-only imports (erased by Node).
    BleClientPort is still derived from the real module, so the port type
    stays tied to the plugin. The app singleton moves to lib/app.ts, which
    is where the real client and platform check belong: the store cannot
    hold them because the reconnect test imports the store. Components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
2026-11-04 test(scripting): pin timer/action registry limits and slot reuse
    Fill the timer table to its 16 entries and check that the 17th call returns
    nil without leaving its ref behind, that cancelling a timer frees the slot for
    the next registration, and that berry_cleanup_script() returns every slot.
    Do the same for the 32-entry action table: the 33rd registration is dropped
    before it allocates a ref, and cleanup makes room again.
    Adds .refs helpers to the suite (length and live entries) so a registration
    that fails can be checked for a stranded closure.
    Mutations checked: dropping refs_free() on the timer-full path, dropping
    s_timers[i].in_use = false in berry_cleanup_script(), and raising MAX_A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
2026-11-04 test(scripting): cover timer scheduling and cancel semantics
    Drive berry_timer_tick() through the cases the registry actually promises:
    a one-shot fires once and gives its slot back, a repeating timer fires per
    period and stops on timer_cancel(), a callback can cancel itself, a one-shot
    callback registering a new timer gets its own freed slot, and two timers due in
    the same tick both fire in that one call.
    The due-time check is signed, so arm a timer 256 ms before the 32-bit
    millisecond clock wraps and check it does not fire in the low numbers that
    follow (mutating away the (int32_t) cast makes both this and the period test
    red).
    Also pins timer_every(0): period 0 is the one-shot marker in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
2026-11-04 test(scripting): cover throwing timer callbacks in the registry
    New test_berry_errors suite with a recorder installed through
    berry_set_timer_error_handler(). A repeating timer that raises reports the
    owning script id (41), the raised pair ("boom"/"kaboom"), the entry is not
    retried, its slot is reusable and the value stack returns to the watermark.
    The second case arms a one-shot from inside a callback and checks the same
    contract for a slot that was just reused by that callback.
    The recorder only records; the production handler in protocol.c disables the
    owning script, so a wrong owner id is a real bug rather than a formatting
    detail.
    Mutations checked: passing 0 instead of the snapshot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
2026-11-04 test(scripting): probe .refs churn growth and BE_EXIT error reads
    Two probes, each written against the behaviour the registry promises rather
    than the behaviour it has. Both confirmed a firmware defect, so both are
    TEST_IGNORE'd with the bug session that owns the fix:
    - .refs churn (ses_e5ded8266ffeF7JEMIeF4Y4HJ6, fixed by PR #33): refs_alloc()
    appends and refs_free() only nils the hole. Twenty timer_after/timer_cancel
    cycles grew .refs from 2 to 22 entries. The test asserts length and live
    entries are unchanged by churn. Drop the ignore once #33 is merged.
    - BE_EXIT in a timer callback (ses_e5de7d818ffexLysa6KUGVbQ75): be_pcall()
    copies one stack value for BE_EXIT (be_exec.c copy_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
2026-11-04 test(scripting): trim redundancy in the new registry suites
    Fold the repeated "register past the limit" chunk into timer_overflowed(),
    drop script globals nothing asserts (fired, outer_h, second_overflow), and
    remove test comments that only restate the test name.
    No behaviour change: test_berry_timers 12 pass + 1 skip, test_berry_errors
    2 pass + 1 skip.
2026-11-04 test(scripting): point the ignored probes at their fix PRs
    Replace the local session ids in the TEST_IGNORE messages with the defect
    one-liner, and name the fix PR in the comment above each probe (#33 for the
    .refs growth, #38 for the BE_EXIT read). A session id is meaningless outside
    the machine that created it; the PR is the durable handle.
2026-11-12 chore: point repository links at opencartools org
    The repo moved from dzid26/ESP32-DualCAN to opencartools/ESP32-DualCAN.
    GitHub redirects repository URLs but not the GitHub Pages origin
    (dzid26.github.io/ESP32-DualCAN now 404s), so update the docs, the
    web UI store links, GitHub API/release fetches and the clone command.
